icprog/FaboolDSPcba/README.md

#FABOOL Laser DS PCBA
- Product page: https://www.smartdiys.cc/fabool-laser-ds/
- Shop page: https://shop.smartdiys.cc/collections/80w-co2-laser-cutter-and-engraver
