icprog/FaboolDSPcba/LaserDSBoard/report.txt

情報: ネットリストファイル "D:\work\FaboolDSPcba\LaserDSBoard\LaserDSBoard.net"を読み込んでいます。

情報: コンポーネントとフットプリントの関連付けにリファレンスを使用

* 警告: コンポーネント 'J3' ：ボードのフットプリント 'B2B-XH-A' ：ネットリストのフットプリント 'mylib:VH-4'

* 警告: コンポーネント 'J15' ：ボードのフットプリント 'B4B-XH-A' ：ネットリストのフットプリント 'mylib:VH-4'

* 警告: コンポーネント 'J14' ：ボードのフットプリント 'B4B-XH-A' ：ネットリストのフットプリント 'mylib:VH-4'

* 警告: コンポーネント 'J16' ：ボードのフットプリント 'B4B-XH-A' ：ネットリストのフットプリント 'mylib:VH-4'

* 警告: コンポーネント 'U14' ：ボードのフットプリント 'TLP2355' ：ネットリストのフットプリント 'mylib:TLP2355'

* 警告: コンポーネント 'U12' ：ボードのフットプリント 'TLP2355' ：ネットリストのフットプリント 'mylib:TLP2355'

* 警告: コンポーネント 'U7' ：ボードのフットプリント 'TLP627' ：ネットリストのフットプリント 'mylib:TLP2355'

* 警告: コンポーネント 'U8' ：ボードのフットプリント 'TSSOP-20' ：ネットリストのフットプリント 'mylib:TLP2355'

* 警告: コンポーネント 'U9' ：ボードのフットプリント 'TLP627' ：ネットリストのフットプリント 'mylib:TLP2355'

* 警告: コンポーネント 'U10' ：ボードのフットプリント 'TSSOP-14' ：ネットリストのフットプリント 'mylib:TLP2355'

* 警告: コンポーネント 'U13' ：ボードのフットプリント 'TLP2355' ：ネットリストのフットプリント 'mylib:TLP2355'

* 警告: コンポーネント 'U17' ：ボードのフットプリント 'TLP2355' ：ネットリストのフットプリント 'mylib:TLP2355'

* 警告: コンポーネント 'U18' ：ボードのフットプリント 'TSOP-5' ：ネットリストのフットプリント 'mylib:TLP2355'

* 警告: コンポーネント 'U15' ：ボードのフットプリント 'TLP2355' ：ネットリストのフットプリント 'mylib:TLP2355'

* 警告: コンポーネント 'U22' ：ボードのフットプリント 'TLP2355' ：ネットリストのフットプリント 'mylib:TLP2355'

* 警告: コンポーネント 'U16' ：ボードのフットプリント 'TLP2355' ：ネットリストのフットプリント 'mylib:TLP2355'

* 警告: コンポーネント 'U6' ：ボードのフットプリント 'TLP627-4' ：ネットリストのフットプリント 'mylib:TLP2355'

* 警告: コンポーネント 'SW2' ：ボードのフットプリント 'MS-22D18' ：ネットリストのフットプリント 'mylib:SSSS213202'

* 警告: コンポーネント 'J10' ：ボードのフットプリント 'B2B-XH-A' ：ネットリストのフットプリント 'mylib:S3B-XH-SM4-TB'

* 警告: コンポーネント 'J5' ：ボードのフットプリント 'B2B-XH-A' ：ネットリストのフットプリント 'mylib:S3B-XH-SM4-TB'

* 警告: コンポーネント 'J7' ：ボードのフットプリント 'B2B-XH-A' ：ネットリストのフットプリント 'mylib:S3B-XH-SM4-TB'

* 警告: コンポーネント 'J8' ：ボードのフットプリント 'B2B-XH-A' ：ネットリストのフットプリント 'mylib:S3B-XH-SM4-TB'

* 警告: コンポーネント 'J9' ：ボードのフットプリント 'B2B-XH-A' ：ネットリストのフットプリント 'mylib:S3B-XH-SM4-TB'

* 警告: コンポーネント 'J4' ：ボードのフットプリント 'B2B-XH-A' ：ネットリストのフットプリント 'mylib:S3B-XH-SM4-TB'

* 警告: コンポーネント 'J11' ：ボードのフットプリント 'B3B-XH-A' ：ネットリストのフットプリント 'mylib:S3B-XH-SM4-TB'

* 警告: コンポーネント 'J6' ：ボードのフットプリント 'B3B-XH-A' ：ネットリストのフットプリント 'mylib:S3B-XH-SM4-TB'

* 警告: コンポーネント 'U19' ：ボードのフットプリント 'SOT23_6' ：ネットリストのフットプリント 'mylib:MCP3425'

* 警告: コンポーネント 'U1' ：ボードのフットプリント 'SOT-223' ：ネットリストのフットプリント 'mylib:LD1117S33TR'

* 警告: コンポーネント 'U4' ：ボードのフットプリント 'SOT-223' ：ネットリストのフットプリント 'mylib:LD1117S33TR'

* 警告: コンポーネント 'U2' ：ボードのフットプリント 'SOT-223' ：ネットリストのフットプリント 'mylib:LD1117S33TR'

* 警告: コンポーネント 'SW1' ：ボードのフットプリント 'DHT-1163S' ：ネットリストのフットプリント 'mylib:DHT-1163S'

* 警告: コンポーネント 'L1' ：ボードのフットプリント 'C_0805' ：ネットリストのフットプリント 'mylib:BNX024H01'

* 警告: コンポーネント 'U11' ：ボードのフットプリント 'SOIC-8' ：ネットリストのフットプリント 'mylib:ADUM1250'

* 警告: コンポーネント 'U20' ：ボードのフットプリント 'TSSOP-24-thin_pads' ：ネットリストのフットプリント 'mylib:A4982SLPTR'

* 警告: コンポーネント 'U21' ：ボードのフットプリント 'TSSOP-24-thin_pads' ：ネットリストのフットプリント 'mylib:A4982SLPTR'

* 警告: コンポーネント 'R37' ：ボードのフットプリント 'R_0603' ：ネットリストのフットプリント 'Resistors_SMD:R_1206'

* 警告: コンポーネント 'R28' ：ボードのフットプリント 'R_0603' ：ネットリストのフットプリント 'Resistors_SMD:R_1206'

* 警告: コンポーネント 'R41' ：ボードのフットプリント 'R_1206' ：ネットリストのフットプリント 'Resistors_SMD:R_1206'

* 警告: コンポーネント 'R4' ：ボードのフットプリント 'R_0603' ：ネットリストのフットプリント 'Resistors_SMD:R_1206'

* 警告: コンポーネント 'R65' ：ボードのフットプリント 'R_1206' ：ネットリストのフットプリント 'Resistors_SMD:R_1206'

* 警告: コンポーネント 'R6' ：ボードのフットプリント 'R_1206' ：ネットリストのフットプリント 'Resistors_SMD:R_1206'

* 警告: コンポーネント 'R40' ：ボードのフットプリント 'R_0603' ：ネットリストのフットプリント 'Resistors_SMD:R_1206'

* 警告: コンポーネント 'R57' ：ボードのフットプリント 'R_0603' ：ネットリストのフットプリント 'Resistors_SMD:R_1206'

* 警告: コンポーネント 'R59' ：ボードのフットプリント 'R_0603' ：ネットリストのフットプリント 'Resistors_SMD:R_1206'

* 警告: コンポーネント 'R58' ：ボードのフットプリント 'R_0603' ：ネットリストのフットプリント 'Resistors_SMD:R_1206'

* 警告: コンポーネント 'R9' ：ボードのフットプリント 'R_1206' ：ネットリストのフットプリント 'Resistors_SMD:R_1206'

* 警告: コンポーネント 'R17' ：ボードのフットプリント 'R_1206' ：ネットリストのフットプリント 'Resistors_SMD:R_1206'

* 警告: コンポーネント 'R16' ：ボードのフットプリント 'R_1206' ：ネットリストのフットプリント 'Resistors_SMD:R_1206'

* 警告: コンポーネント 'R15' ：ボードのフットプリント 'R_1206' ：ネットリストのフットプリント 'Resistors_SMD:R_1206'

* 警告: コンポーネント 'R60' ：ボードのフットプリント 'R_0603' ：ネットリストのフットプリント 'Resistors_SMD:R_1206'

* 警告: コンポーネント 'R10' ：ボードのフットプリント 'R_1206' ：ネットリストのフットプリント 'Resistors_SMD:R_1206'

* 警告: コンポーネント 'R56' ：ボードのフットプリント 'R_0603' ：ネットリストのフットプリント 'Resistors_SMD:R_1206'

* 警告: コンポーネント 'R51' ：ボードのフットプリント 'R_0603' ：ネットリストのフットプリント 'Resistors_SMD:R_1206'

* 警告: コンポーネント 'R55' ：ボードのフットプリント 'R_0603' ：ネットリストのフットプリント 'Resistors_SMD:R_1206'

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

コンポーネントを "C21:/56CE9D67" ピン "2" ネット名を， "GND" から "GNDD" に変更．

情報: ネットリストよりコンポーネントとフットプリントをチェックしています "C22:/56DE961B:Capacitors_SMD:C_0805"。

コンポーネントを "C22:/56DE961B" ピン "1" ネット名を， "+3.3V" から "D+3.3V" に変更．

コンポーネントを "C22:/56DE961B" ピン "2" ネット名を， "GND" から "GNDD" に変更．

情報: ネットリストよりコンポーネントとフットプリントをチェックしています "C23:/5A8243E8:Capacitors_SMD:C_0805"。

コンポーネント "C23:/5A35896F" の値を， "0u1" から "0.1u" に変更．

情報: コンポーネントのパス， "C23:/5A35896F" を "/5A8243E8" に変更．

コンポーネントを "C23:/5A8243E8" ピン "1" ネット名を， "GND" から "A+12V" に変更．

コンポーネントを "C23:/5A8243E8" ピン "2" ネット名を， "X_LIMIT1" から "GNDA" に変更．

情報: ネットリストよりコンポーネントとフットプリントをチェックしています "C24:/5A7D0A2E:Capacitors_SMD:C_0805"。

情報: コンポーネントのパス， "C24:/5A35898F" を "/5A7D0A2E" に変更．

コンポーネントを "C24:/5A7D0A2E" ピン "1" ネット名を， "GND" から "A+3.3V" に変更．

コンポーネントを "C24:/5A7D0A2E" ピン "2" ネット名を， "X_LIMIT2" から "GNDA" に変更．

情報: ネットリストよりコンポーネントとフットプリントをチェックしています "C25:/5A83414A:Capacitors_SMD:C_0805"。

情報: コンポーネントのパス， "C25:/5A3589AF" を "/5A83414A" に変更．

コンポーネントを "C25:/5A83414A" ピン "1" ネット名を， "GND" から "X_LIMIT1" に変更．

コンポーネントを "C25:/5A83414A" ピン "2" ネット名を， "Y_LIMIT1" から "GNDD" に変更．

情報: ネットリストよりコンポーネントとフットプリントをチェックしています "C26:/5A8343A4:Capacitors_SMD:C_0805"。

情報: コンポーネントのパス， "C26:/5A3589CF" を "/5A8343A4" に変更．

コンポーネントを "C26:/5A8343A4" ピン "1" ネット名を， "GND" から "X_LIMIT2" に変更．

コンポーネントを "C26:/5A8343A4" ピン "2" ネット名を， "Y_LIMIT2" から "GNDD" に変更．

情報: ネットリストよりコンポーネントとフットプリントをチェックしています "C27:/5A358B85:Capacitors_SMD:C_0805"。

コンポーネントを "C27:/5A358B85" ピン "1" ネット名を， "DGND" から "GNDA" に変更．

コンポーネントを "C27:/5A358B85" ピン "2" ネット名を， "D33V" から "A+3.3V" に変更．

情報: ネットリストよりコンポーネントとフットプリントをチェックしています "C28:/5A8345DB:Capacitors_SMD:C_0805"。

情報: コンポーネントのパス， "C28:/56CEA9CC" を "/5A8345DB" に変更．

コンポーネントを "C28:/5A8345DB" ピン "1" ネット名を， "GND" から "Y_LIMIT1" に変更．

コンポーネントを "C28:/5A8345DB" ピン "2" ネット名を， "D_SWITCH" から "GNDD" に変更．

情報: ネットリストよりコンポーネントとフットプリントをチェックしています "C29:/56CEA8C7:Capacitors_SMD:C_0805"。

コンポーネントを "C29:/56CEA8C7" ピン "1" ネット名を， "D33V" から "A+3.3V" に変更．

コンポーネントを "C29:/56CEA8C7" ピン "2" ネット名を， "DGND" から "GNDA" に変更．

情報: ネットリストよりコンポーネントとフットプリントをチェックしています "C30:/5A353B5C:Capacitors_SMD:C_0805"。

コンポーネントを "C30:/5A353B5C" ピン "1" ネット名を， "+3.3V" から "D+3.3V" に変更．

コンポーネントを "C30:/5A353B5C" ピン "2" ネット名を， "GND" から "GNDD" に変更．

情報: ネットリストよりコンポーネントとフットプリントをチェックしています "C31:/5A354B5E:Capacitors_SMD:C_0805"。

コンポーネントを "C31:/5A354B5E" ピン "1" ネット名を， "D33V" から "A+3.3V" に変更．

コンポーネントを "C31:/5A354B5E" ピン "2" ネット名を， "DGND" から "GNDA" に変更．

情報: ネットリストよりコンポーネントとフットプリントをチェックしています "C32:/56CEA932:Capacitors_SMD:C_0603"。

コンポーネントを "C32:/56CEA932" ピン "1" ネット名を， "N-0000055" から "Net-(C32-Pad1)" に変更．

コンポーネントを "C32:/56CEA932" ピン "2" ネット名を， "DGND" から "GNDA" に変更．

情報: ネットリストよりコンポーネントとフットプリントをチェックしています "C33:/5A354834:Capacitors_SMD:C_0805"。

コンポーネントを "C33:/5A354834" ピン "1" ネット名を， "N-00000100" から "Net-(C33-Pad1)" に変更．

コンポーネントを "C33:/5A354834" ピン "2" ネット名を， "DGND" から "GNDA" に変更．

情報: ネットリストよりコンポーネントとフットプリントをチェックしています "C34:/56CEA9A0:Capacitors_SMD:C_0603"。

コンポーネントを "C34:/56CEA9A0" ピン "1" ネット名を， "N-0000065" から "Net-(C34-Pad1)" に変更．

コンポーネントを "C34:/56CEA9A0" ピン "2" ネット名を， "DGND" から "GNDA" に変更．

情報: ネットリストよりコンポーネントとフットプリントをチェックしています "C35:/56CEA852:Capacitors_SMD:C_0805"。

コンポーネントを "C35:/56CEA852" ピン "1" ネット名を， "DGND" から "GNDA" に変更．

コンポーネントを "C35:/56CEA852" ピン "2" ネット名を， "D12V" から "A+12V" に変更．

情報: ネットリストよりコンポーネントとフットプリントをチェックしています "C36:/56CEA858:Capacitors_SMD:C_0805"。

コンポーネントを "C36:/56CEA858" ピン "1" ネット名を， "DGND" から "GNDA" に変更．

コンポーネントを "C36:/56CEA858" ピン "2" ネット名を， "D12V" から "A+12V" に変更．

情報: ネットリストよりコンポーネントとフットプリントをチェックしています "C37:/56CEA8D9:Capacitors_SMD:CP_Elec_6.3x7.7"。

コンポーネントを "C37:/56CEA8D9" ピン "1" ネット名を， "D12V" から "A+12V" に変更．

コンポーネントを "C37:/56CEA8D9" ピン "2" ネット名を， "DGND" から "GNDA" に変更．

情報: ネットリストよりコンポーネントとフットプリントをチェックしています "C38:/56CEA8DF:Capacitors_SMD:CP_Elec_6.3x7.7"。

コンポーネントを "C38:/56CEA8DF" ピン "1" ネット名を， "D12V" から "A+12V" に変更．

コンポーネントを "C38:/56CEA8DF" ピン "2" ネット名を， "DGND" から "GNDA" に変更．

情報: ネットリストよりコンポーネントとフットプリントをチェックしています "C39:/5A354B64:Capacitors_SMD:C_0805"。

コンポーネントを "C39:/5A354B64" ピン "1" ネット名を， "D33V" から "A+3.3V" に変更．

コンポーネントを "C39:/5A354B64" ピン "2" ネット名を， "DGND" から "GNDA" に変更．

情報: ネットリストよりコンポーネントとフットプリントをチェックしています "C40:/56CEA93E:Capacitors_SMD:C_0805"。

コンポーネントを "C40:/56CEA93E" ピン "1" ネット名を， "N-0000056" から "Net-(C40-Pad1)" に変更．

コンポーネントを "C40:/56CEA93E" ピン "2" ネット名を， "D12V" から "A+12V" に変更．

情報: ネットリストよりコンポーネントとフットプリントをチェックしています "C41:/56CEA994:Capacitors_SMD:C_0805"。

コンポーネントを "C41:/56CEA994" ピン "1" ネット名を， "N-0000070" から "Net-(C41-Pad1)" に変更．

コンポーネントを "C41:/56CEA994" ピン "2" ネット名を， "D12V" から "A+12V" に変更．

情報: ネットリストよりコンポーネントとフットプリントをチェックしています "C42:/56CEA94A:Capacitors_SMD:C_0603"。

コンポーネントを "C42:/56CEA94A" ピン "1" ネット名を， "D33V" から "A+3.3V" に変更．

コンポーネントを "C42:/56CEA94A" ピン "2" ネット名を， "DGND" から "GNDA" に変更．

情報: ネットリストよりコンポーネントとフットプリントをチェックしています "C43:/56CEA988:Capacitors_SMD:C_0603"。

コンポーネントを "C43:/56CEA988" ピン "1" ネット名を， "D33V" から "A+3.3V" に変更．

コンポーネントを "C43:/56CEA988" ピン "2" ネット名を， "DGND" から "GNDA" に変更．

情報: ネットリストよりコンポーネントとフットプリントをチェックしています "C44:/56CEA81C:Capacitors_SMD:C_0805"。

コンポーネントを "C44:/56CEA81C" ピン "1" ネット名を， "N-0000040" から "Net-(C44-Pad1)" に変更．

コンポーネントを "C44:/56CEA81C" ピン "2" ネット名を， "N-0000039" から "Net-(C44-Pad2)" に変更．

情報: ネットリストよりコンポーネントとフットプリントをチェックしています "C45:/56CEA822:Capacitors_SMD:C_0805"。

コンポーネントを "C45:/56CEA822" ピン "1" ネット名を， "N-0000037" から "Net-(C45-Pad1)" に変更．

コンポーネントを "C45:/56CEA822" ピン "2" ネット名を， "N-0000038" から "Net-(C45-Pad2)" に変更．

情報: ネットリストよりコンポーネントとフットプリントをチェックしています "C46:/56CEA86B:Capacitors_SMD:C_0805"。

コンポーネントを "C46:/56CEA86B" ピン "2" ネット名を， "DGND" から "GNDA" に変更．

情報: ネットリストよりコンポーネントとフットプリントをチェックしています "C47:/56CEA871:Capacitors_SMD:C_0805"。

コンポーネントを "C47:/56CEA871" ピン "2" ネット名を， "DGND" から "GNDA" に変更．

情報: ネットリストよりコンポーネントとフットプリントをチェックしています "C48:/5A834815:Capacitors_SMD:C_0805"。

コンポーネント "C48:/5A834815" フットプリント "Capacitors_SMD:C_0805" を追加します。

コンポーネントを "C48:/5A834815" ピン "1" ネット名を， "" から "Y_LIMIT2" に変更．

コンポーネントを "C48:/5A834815" ピン "2" ネット名を， "" から "GNDD" に変更．

情報: ネットリストよりコンポーネントとフットプリントをチェックしています "C49:/5A8A227D:Capacitors_SMD:C_0805"。

コンポーネント "C49:/5A8A227D" フットプリント "Capacitors_SMD:C_0805" を追加します。

コンポーネントを "C49:/5A8A227D" ピン "1" ネット名を， "" から "D_SWITCH" に変更．

コンポーネントを "C49:/5A8A227D" ピン "2" ネット名を， "" から "GNDD" に変更．

情報: ネットリストよりコンポーネントとフットプリントをチェックしています "C50:/5A990A10:Capacitors_SMD:C_0603"。

コンポーネント "C50:/5A990A10" フットプリント "Capacitors_SMD:C_0603" を追加します。

コンポーネントを "C50:/5A990A10" ピン "2" ネット名を， "" から "GNDA" に変更．

コンポーネントを "C50:/5A990A10" ピン "1" ネット名を， "" から "Net-(C50-Pad1)" に変更．

情報: ネットリストよりコンポーネントとフットプリントをチェックしています "C51:/5A9909F1:Capacitors_SMD:C_0805"。

コンポーネント "C51:/5A9909F1" フットプリント "Capacitors_SMD:C_0805" を追加します。

コンポーネントを "C51:/5A9909F1" ピン "1" ネット名を， "" から "GNDA" に変更．

コンポーネントを "C51:/5A9909F1" ピン "2" ネット名を， "" から "A+12V" に変更．

情報: ネットリストよりコンポーネントとフットプリントをチェックしています "C52:/5A9909FD:Capacitors_SMD:CP_Elec_6.3x7.7"。

コンポーネント "C52:/5A9909FD" フットプリント "Capacitors_SMD:CP_Elec_6.3x7.7" を追加します。

コンポーネントを "C52:/5A9909FD" ピン "1" ネット名を， "" から "A+12V" に変更．

コンポーネントを "C52:/5A9909FD" ピン "2" ネット名を， "" から "GNDA" に変更．

情報: ネットリストよりコンポーネントとフットプリントをチェックしています "C53:/5A990A1C:Capacitors_SMD:C_0805"。

コンポーネント "C53:/5A990A1C" フットプリント "Capacitors_SMD:C_0805" を追加します。

コンポーネントを "C53:/5A990A1C" ピン "1" ネット名を， "" から "Net-(C53-Pad1)" に変更．

コンポーネントを "C53:/5A990A1C" ピン "2" ネット名を， "" から "A+12V" に変更．

情報: ネットリストよりコンポーネントとフットプリントをチェックしています "C54:/5A990A28:Capacitors_SMD:C_0603"。

コンポーネント "C54:/5A990A28" フットプリント "Capacitors_SMD:C_0603" を追加します。

コンポーネントを "C54:/5A990A28" ピン "2" ネット名を， "" から "GNDA" に変更．

コンポーネントを "C54:/5A990A28" ピン "1" ネット名を， "" から "A+3.3V" に変更．

情報: ネットリストよりコンポーネントとフットプリントをチェックしています "C55:/5A9909E5:Capacitors_SMD:C_0805"。

コンポーネント "C55:/5A9909E5" フットプリント "Capacitors_SMD:C_0805" を追加します。

コンポーネントを "C55:/5A9909E5" ピン "1" ネット名を， "" から "Net-(C55-Pad1)" に変更．

コンポーネントを "C55:/5A9909E5" ピン "2" ネット名を， "" から "Net-(C55-Pad2)" に変更．

情報: ネットリストよりコンポーネントとフットプリントをチェックしています "C56:/5A9909F7:Capacitors_SMD:C_0805"。

コンポーネント "C56:/5A9909F7" フットプリント "Capacitors_SMD:C_0805" を追加します。

コンポーネントを "C56:/5A9909F7" ピン "1" ネット名を， "" から "Y_REF" に変更．

コンポーネントを "C56:/5A9909F7" ピン "2" ネット名を， "" から "GNDA" に変更．

情報: ネットリストよりコンポーネントとフットプリントをチェックしています "D1:/56CEA9E9:Diodes_SMD:D_0603"。

コンポーネントを "D1:/56CEA9E9" ピン "2" ネット名を， "N-00000110" から "Net-(D1-Pad2)" に変更．

情報: ネットリストよりコンポーネントとフットプリントをチェックしています "D2:/56CEA807:Diodes_SMD:D_0603"。

コンポーネントを "D2:/56CEA807" ピン "2" ネット名を， "N-0000051" から "Net-(D2-Pad2)" に変更．

コンポーネントを "D2:/56CEA807" ピン "1" ネット名を， "D12V" から "A+12V" に変更．

情報: ネットリストよりコンポーネントとフットプリントをチェックしています "D3:/5A3574DD:Diodes_SMD:D_0603"。

コンポーネントを "D3:/5A3574DD" ピン "2" ネット名を， "N-00000119" から "Net-(D3-Pad2)" に変更．

コンポーネントを "D3:/5A3574DD" ピン "1" ネット名を， "D33V" から "A+3.3V" に変更．

情報: ネットリストよりコンポーネントとフットプリントをチェックしています "D4:/56CEA7EF:Diodes_SMD:D_0603"。

コンポーネントを "D4:/56CEA7EF" ピン "2" ネット名を， "N-0000050" から "Net-(D4-Pad2)" に変更．

コンポーネントを "D4:/56CEA7EF" ピン "1" ネット名を， "D5V" から "A+5V" に変更．

情報: ネットリストよりコンポーネントとフットプリントをチェックしています "D5:/5A7F41D8:Diodes_SMD:D_0603"。

情報: コンポーネントのパス， "D5:/56CEA8A1" を "/5A7F41D8" に変更．

コンポーネントを "D5:/5A7F41D8" ピン "2" ネット名を， "N-0000094" から "Net-(D5-Pad2)" に変更．

コンポーネントを "D5:/5A7F41D8" ピン "1" ネット名を， "N-0000049" から "Net-(D5-Pad1)" に変更．

情報: ネットリストよりコンポーネントとフットプリントをチェックしています "D6:/5A7FC4C0:Diodes_SMD:D_0603"。

情報: コンポーネントのパス， "D6:/57C27BDA" を "/5A7FC4C0" に変更．

コンポーネントを "D6:/5A7FC4C0" ピン "2" ネット名を， "N-0000093" から "Net-(D6-Pad2)" に変更．

コンポーネントを "D6:/5A7FC4C0" ピン "1" ネット名を， "N-0000045" から "Net-(D6-Pad1)" に変更．

情報: ネットリストよりコンポーネントとフットプリントをチェックしています "D7:/5A7FCD76:Diodes_SMD:D_0603"。

情報: コンポーネントのパス， "D7:/56CEA889" を "/5A7FCD76" に変更．

コンポーネントを "D7:/5A7FCD76" ピン "2" ネット名を， "N-0000092" から "Net-(D7-Pad2)" に変更．

コンポーネントを "D7:/5A7FCD76" ピン "1" ネット名を， "N-0000044" から "Net-(D7-Pad1)" に変更．

情報: ネットリストよりコンポーネントとフットプリントをチェックしています "D8:/5A7FCFA8:Diodes_SMD:D_0603"。

情報: コンポーネントのパス， "D8:/57C27BB0" を "/5A7FCFA8" に変更．

コンポーネントを "D8:/5A7FCFA8" ピン "2" ネット名を， "N-0000095" から "Net-(D8-Pad2)" に変更．

コンポーネントを "D8:/5A7FCFA8" ピン "1" ネット名を， "N-0000043" から "Net-(D8-Pad1)" に変更．

情報: ネットリストよりコンポーネントとフットプリントをチェックしています "D9:/56CEA9BE:Diodes_SMD:D_0603"。

コンポーネントを "D9:/56CEA9BE" ピン "2" ネット名を， "N-0000079" から "Net-(D9-Pad2)" に変更．

コンポーネントを "D9:/56CEA9BE" ピン "1" ネット名を， "N-0000078" から "Net-(D9-Pad1)" に変更．

情報: ネットリストよりコンポーネントとフットプリントをチェックしています "J1:/56CEB228:Pin_Headers:Pin_Header_Straight_2x05_Pitch1.00mm"。

コンポーネントを "J1:/56CEB228" ピン "1" ネット名を， "+3.3V" から "D+3.3V" に変更．

コンポーネントを "J1:/56CEB228" ピン "3" ネット名を， "GND" から "GNDD" に変更．

コンポーネントを "J1:/56CEB228" ピン "5" ネット名を， "GND" から "GNDD" に変更．

コンポーネントを "J1:/56CEB228" ピン "7" ネット名を， "" から "Net-(J1-Pad7)" に変更．

コンポーネントを "J1:/56CEB228" ピン "9" ネット名を， "GND" から "GNDD" に変更．

情報: ネットリストよりコンポーネントとフットプリントをチェックしています "J2:/56CEAA33:Connect:USB_B"。

コンポーネントを "J2:/56CEAA33" ピン "2" ネット名を， "N-00000116" から "Net-(J2-Pad2)" に変更．

コンポーネントを "J2:/56CEAA33" ピン "3" ネット名を， "N-00000117" から "Net-(J2-Pad3)" に変更．

コンポーネントを "J2:/56CEAA33" ピン "4" ネット名を， "GND" から "GNDD" に変更．

コンポーネントを "J2:/56CEAA33" ピン "5" ネット名を， "N-00000115" から "GNDD" に変更．

コンポーネントを "J2:/56CEAA33" ピン "6" ネット名を， "N-00000115" から "GNDD" に変更．

情報: ネットリストよりコンポーネントとフットプリントをチェックしています "J3:/57C28AB0:mylib:VH-4"。

コンポーネントを "J3:/57C28AB0" ピン "1" ネット名を， "N-00000106" から "+12P" に変更．

コンポーネントを "J3:/57C28AB0" ピン "2" ネット名を， "N-00000105" から "GNDPWR" に変更．

情報: ネットリストよりコンポーネントとフットプリントをチェックしています "J4:/57C2B94C:mylib:S3B-XH-SM4-TB"。

コンポーネントを "J4:/57C2B94C" ピン "1" ネット名を， "N-0000099" から "Net-(J4-Pad1)" に変更．

コンポーネントを "J4:/57C2B94C" ピン "2" ネット名を， "DGND" から "GNDA" に変更．

情報: ネットリストよりコンポーネントとフットプリントをチェックしています "J5:/5A7B96E2:mylib:S3B-XH-SM4-TB"。

コンポーネント "J5:/56CEABED" の値を， "D SWITCH" から "X LIMIT1" に変更．

情報: コンポーネントのパス， "J5:/56CEABED" を "/5A7B96E2" に変更．

コンポーネントを "J5:/5A7B96E2" ピン "1" ネット名を， "N-0000079" から "Net-(D5-Pad2)" に変更．

コンポーネントを "J5:/5A7B96E2" ピン "2" ネット名を， "DGND" から "GNDA" に変更．

情報: ネットリストよりコンポーネントとフットプリントをチェックしています "J6:/5A353B1D:mylib:S3B-XH-SM4-TB"。

コンポーネントを "J6:/5A353B1D" ピン "1" ネット名を， "D33V" から "A+3.3V" に変更．

コンポーネントを "J6:/5A353B1D" ピン "2" ネット名を， "DGND" から "GNDA" に変更．

コンポーネントを "J6:/5A353B1D" ピン "3" ネット名を， "N-0000082" から "Net-(J6-Pad3)" に変更．

情報: ネットリストよりコンポーネントとフットプリントをチェックしています "J7:/5A7BB8D3:mylib:S3B-XH-SM4-TB"。

コンポーネント "J7:/56CEABD5" の値を， "X LIMIT1" から "X LIMIT2" に変更．

情報: コンポーネントのパス， "J7:/56CEABD5" を "/5A7BB8D3" に変更．

コンポーネントを "J7:/5A7BB8D3" ピン "1" ネット名を， "N-0000094" から "Net-(D6-Pad2)" に変更．

コンポーネントを "J7:/5A7BB8D3" ピン "2" ネット名を， "DGND" から "GNDA" に変更．

情報: ネットリストよりコンポーネントとフットプリントをチェックしています "J8:/5A7BBADF:mylib:S3B-XH-SM4-TB"。

コンポーネント "J8:/57C2BE86" の値を， "X LIMIT2" から "Y LIMIT1" に変更．

情報: コンポーネントのパス， "J8:/57C2BE86" を "/5A7BBADF" に変更．

コンポーネントを "J8:/5A7BBADF" ピン "1" ネット名を， "N-0000093" から "Net-(D7-Pad2)" に変更．

コンポーネントを "J8:/5A7BBADF" ピン "2" ネット名を， "DGND" から "GNDA" に変更．

情報: ネットリストよりコンポーネントとフットプリントをチェックしています "J9:/5A7BBCEA:mylib:S3B-XH-SM4-TB"。

コンポーネント "J9:/56CEABE1" の値を， "Y LIMIT1" から "Y LIMIT2" に変更．

情報: コンポーネントのパス， "J9:/56CEABE1" を "/5A7BBCEA" に変更．

コンポーネントを "J9:/5A7BBCEA" ピン "1" ネット名を， "N-0000092" から "Net-(D8-Pad2)" に変更．

コンポーネントを "J9:/5A7BBCEA" ピン "2" ネット名を， "DGND" から "GNDA" に変更．

情報: ネットリストよりコンポーネントとフットプリントをチェックしています "J10:/5A892CFF:mylib:S3B-XH-SM4-TB"。

コンポーネント "J10:/57C2BE96" の値を， "Y LIMIT2" から "D SWITCH" に変更．

情報: コンポーネントのパス， "J10:/57C2BE96" を "/5A892CFF" に変更．

コンポーネントを "J10:/5A892CFF" ピン "1" ネット名を， "N-0000095" から "Net-(D9-Pad2)" に変更．

コンポーネントを "J10:/5A892CFF" ピン "2" ネット名を， "DGND" から "GNDA" に変更．

情報: ネットリストよりコンポーネントとフットプリントをチェックしています "J11:/5A9B8B22:mylib:S3B-XH-SM4-TB"。

情報: コンポーネントのパス， "J11:/57C30135" を "/5A9B8B22" に変更．

コンポーネントを "J11:/5A9B8B22" ピン "1" ネット名を， "N-00000114" から "Net-(J11-Pad1)" に変更．

コンポーネントを "J11:/5A9B8B22" ピン "2" ネット名を， "" から "Net-(J11-Pad2)" に変更．

コンポーネントを "J11:/5A9B8B22" ピン "3" ネット名を， "DGND" から "GNDA" に変更．

情報: ネットリストよりコンポーネントとフットプリントをチェックしています "J12:/56CEA846:Pin_Headers:Pin_Header_Straight_1x01_Pitch1.00mm"。

情報: ネットリストよりコンポーネントとフットプリントをチェックしています "J13:/56CEA840:Pin_Headers:Pin_Header_Straight_1x01_Pitch1.00mm"。

情報: ネットリストよりコンポーネントとフットプリントをチェックしています "J14:/56CEAA51:mylib:VH-4"。

コンポーネントを "J14:/56CEAA51" ピン "1" ネット名を， "Y_MOT_2B" から "Y1_MOT_2B" に変更．

コンポーネントを "J14:/56CEAA51" ピン "2" ネット名を， "Y_MOT_2A" から "Y1_MOT_2A" に変更．

コンポーネントを "J14:/56CEAA51" ピン "3" ネット名を， "Y_MOT_1A" から "Y1_MOT_1A" に変更．

コンポーネントを "J14:/56CEAA51" ピン "4" ネット名を， "Y_MOT_1B" から "Y1_MOT_1B" に変更．

情報: ネットリストよりコンポーネントとフットプリントをチェックしています "J15:/56CEAA4B:mylib:VH-4"。

情報: ネットリストよりコンポーネントとフットプリントをチェックしています "J16:/56CEAA57:mylib:VH-4"。

コンポーネントを "J16:/56CEAA57" ピン "1" ネット名を， "Y_MOT_2B" から "Y2_MOT_2B" に変更．

コンポーネントを "J16:/56CEAA57" ピン "2" ネット名を， "Y_MOT_2A" から "Y2_MOT_2A" に変更．

コンポーネントを "J16:/56CEAA57" ピン "3" ネット名を， "Y_MOT_1A" から "Y2_MOT_1A" に変更．

コンポーネントを "J16:/56CEAA57" ピン "4" ネット名を， "Y_MOT_1B" から "Y2_MOT_1B" に変更．

情報: ネットリストよりコンポーネントとフットプリントをチェックしています "J17:/5A9909EB:Pin_Headers:Pin_Header_Straight_1x01_Pitch1.00mm"。

コンポーネント "J17:/5A9909EB" フットプリント "Pin_Headers:Pin_Header_Straight_1x01_Pitch1.00mm" を追加します。

コンポーネントを "J17:/5A9909EB" ピン "1" ネット名を， "" から "Y_REF" に変更．

情報: ネットリストよりコンポーネントとフットプリントをチェックしています "L1:/5A80D58A:mylib:BNX024H01"。

コンポーネント "L1:/586DF2CD" の値を， "BLM21SN300SN1D" から "BNX024H01" に変更．

情報: コンポーネントのパス， "L1:/586DF2CD" を "/5A80D58A" に変更．

コンポーネントを "L1:/5A80D58A" ピン "1" ネット名を， "D12V" から "+12P" に変更．

コンポーネントを "L1:/5A80D58A" ピン "2" ネット名を， "N-00000106" から "A+12V" に変更．

情報: ネットリストよりコンポーネントとフットプリントをチェックしています "L4:/56CEB62F:Resistors_SMD:R_0603"。

コンポーネント "L4:/56CEB62F" の値を， "Ferrite bead" から "LI0603G221R-10" に変更．

コンポーネントを "L4:/56CEB62F" ピン "1" ネット名を， "+3.3V" から "D+3.3V" に変更．

情報: ネットリストよりコンポーネントとフットプリントをチェックしています "R1:/5726C39C:Resistors_SMD:R_0603"。

コンポーネントを "R1:/5726C39C" ピン "1" ネット名を， "N-00000108" から "Net-(R1-Pad1)" に変更．

コンポーネントを "R1:/5726C39C" ピン "2" ネット名を， "GND" から "GNDD" に変更．

情報: ネットリストよりコンポーネントとフットプリントをチェックしています "R2:/5A7F3F8A:Resistors_SMD:R_0603"。

コンポーネント "R2:/5A34BFA6" の値を， "220R" から "4k7" に変更．

情報: コンポーネントのパス， "R2:/5A34BFA6" を "/5A7F3F8A" に変更．

コンポーネントを "R2:/5A7F3F8A" ピン "1" ネット名を， "N-00000128" から "Net-(D5-Pad1)" に変更．

コンポーネントを "R2:/5A7F3F8A" ピン "2" ネット名を， "D12V" から "A+12V" に変更．

情報: ネットリストよりコンポーネントとフットプリントをチェックしています "R3:/5A7FC6EC:Resistors_SMD:R_0603"。

コンポーネント "R3:/5A34BFCA" の値を， "220R" から "4k7" に変更．

情報: コンポーネントのパス， "R3:/5A34BFCA" を "/5A7FC6EC" に変更．

コンポーネントを "R3:/5A7FC6EC" ピン "1" ネット名を， "N-00000129" から "Net-(D6-Pad1)" に変更．

コンポーネントを "R3:/5A7FC6EC" ピン "2" ネット名を， "N-00000128" から "A+12V" に変更．

情報: ネットリストよりコンポーネントとフットプリントをチェックしています "R4:/56DE8B17:Resistors_SMD:R_1206"。

コンポーネントを "R4:/56DE8B17" ピン "1" ネット名を， "N-00000110" から "Net-(D1-Pad2)" に変更．

コンポーネントを "R4:/56DE8B17" ピン "2" ネット名を， "GND" から "GNDD" に変更．

情報: ネットリストよりコンポーネントとフットプリントをチェックしています "R5:/5A7FC917:Resistors_SMD:R_0603"。

コンポーネント "R5:/5A34BFB8" の値を， "220R" から "4k7" に変更．

情報: コンポーネントのパス， "R5:/5A34BFB8" を "/5A7FC917" に変更．

コンポーネントを "R5:/5A7FC917" ピン "1" ネット名を， "N-00000127" から "Net-(D7-Pad1)" に変更．

コンポーネントを "R5:/5A7FC917" ピン "2" ネット名を， "D12V" から "A+12V" に変更．

情報: ネットリストよりコンポーネントとフットプリントをチェックしています "R6:/5A9B8B28:Resistors_SMD:R_1206"。

情報: コンポーネントのパス， "R6:/5A34BFD0" を "/5A9B8B28" に変更．

コンポーネントを "R6:/5A9B8B28" ピン "1" ネット名を， "N-00000129" から "Net-(R6-Pad1)" に変更．

コンポーネントを "R6:/5A9B8B28" ピン "2" ネット名を， "N-00000127" から "LASER_OUT" に変更．

情報: ネットリストよりコンポーネントとフットプリントをチェックしています "R7:/5A7FCB45:Resistors_SMD:R_0603"。

コンポーネント "R7:/5A34BFBE" の値を， "220R" から "4k7" に変更．

情報: コンポーネントのパス， "R7:/5A34BFBE" を "/5A7FCB45" に変更．

コンポーネントを "R7:/5A7FCB45" ピン "1" ネット名を， "N-00000126" から "Net-(D8-Pad1)" に変更．

コンポーネントを "R7:/5A7FCB45" ピン "2" ネット名を， "D12V" から "A+12V" に変更．

情報: ネットリストよりコンポーネントとフットプリントをチェックしています "R8:/5A85E8DC:Resistors_SMD:R_0603"。

コンポーネント "R8:/5A34BFD6" の値を， "220R" から "4k7" に変更．

情報: コンポーネントのパス， "R8:/5A34BFD6" を "/5A85E8DC" に変更．

コンポーネントを "R8:/5A85E8DC" ピン "1" ネット名を， "N-00000129" から "Net-(D9-Pad1)" に変更．

コンポーネントを "R8:/5A85E8DC" ピン "2" ネット名を， "N-00000126" から "A+12V" に変更．

情報: ネットリストよりコンポーネントとフットプリントをチェックしています "R9:/5A885D6C:Resistors_SMD:R_1206"。

コンポーネント "R9:/5A34BFC4" の値を， "220R" から "1k" に変更．

情報: コンポーネントのパス， "R9:/5A34BFC4" を "/5A885D6C" に変更．

コンポーネントを "R9:/5A885D6C" ピン "1" ネット名を， "N-00000125" から "A+12V" に変更．

コンポーネントを "R9:/5A885D6C" ピン "2" ネット名を， "D12V" から "Net-(R9-Pad2)" に変更．

情報: ネットリストよりコンポーネントとフットプリントをチェックしています "R10:/5A7DA5C0:Resistors_SMD:R_1206"。

コンポーネント "R10:/5A34BFDC" の値を， "220R" から "1k" に変更．

情報: コンポーネントのパス， "R10:/5A34BFDC" を "/5A7DA5C0" に変更．

コンポーネントを "R10:/5A7DA5C0" ピン "1" ネット名を， "N-00000129" から "A+12V" に変更．

コンポーネントを "R10:/5A7DA5C0" ピン "2" ネット名を， "N-00000125" から "Net-(R10-Pad2)" に変更．

情報: ネットリストよりコンポーネントとフットプリントをチェックしています "R11:/56CEB21F:Resistors_SMD:R_0603"。

コンポーネントを "R11:/56CEB21F" ピン "1" ネット名を， "+3.3V" から "D+3.3V" に変更．

情報: ネットリストよりコンポーネントとフットプリントをチェックしています "R12:/56CEB260:Resistors_SMD:R_0603"。

コンポーネントを "R12:/56CEB260" ピン "1" ネット名を， "+3.3V" から "D+3.3V" に変更．

情報: ネットリストよりコンポーネントとフットプリントをチェックしています "R13:/56CEB219:Resistors_SMD:R_0603"。

コンポーネントを "R13:/56CEB219" ピン "1" ネット名を， "+3.3V" から "D+3.3V" に変更．

情報: ネットリストよりコンポーネントとフットプリントをチェックしています "R14:/56CEB213:Resistors_SMD:R_0603"。

コンポーネントを "R14:/56CEB213" ピン "1" ネット名を， "+3.3V" から "D+3.3V" に変更．

情報: ネットリストよりコンポーネントとフットプリントをチェックしています "R15:/5A7DE331:Resistors_SMD:R_1206"。

コンポーネント "R15:/5A34BFE2" の値を， "220R" から "1k" に変更．

情報: コンポーネントのパス， "R15:/5A34BFE2" を "/5A7DE331" に変更．

コンポーネントを "R15:/5A7DE331" ピン "1" ネット名を， "N-00000124" から "A+12V" に変更．

コンポーネントを "R15:/5A7DE331" ピン "2" ネット名を， "D12V" から "Net-(R15-Pad2)" に変更．

情報: ネットリストよりコンポーネントとフットプリントをチェックしています "R16:/5A7DE544:Resistors_SMD:R_1206"。

コンポーネント "R16:/5A34BFFA" の値を， "220R" から "1k" に変更．

情報: コンポーネントのパス， "R16:/5A34BFFA" を "/5A7DE544" に変更．

コンポーネントを "R16:/5A7DE544" ピン "1" ネット名を， "N-00000130" から "A+12V" に変更．

コンポーネントを "R16:/5A7DE544" ピン "2" ネット名を， "N-00000124" から "Net-(R16-Pad2)" に変更．

情報: ネットリストよりコンポーネントとフットプリントをチェックしています "R17:/5A7DE760:Resistors_SMD:R_1206"。

コンポーネント "R17:/5A34BFE8" の値を， "220R" から "1k" に変更．

情報: コンポーネントのパス， "R17:/5A34BFE8" を "/5A7DE760" に変更．

コンポーネントを "R17:/5A7DE760" ピン "1" ネット名を， "N-00000123" から "A+12V" に変更．

コンポーネントを "R17:/5A7DE760" ピン "2" ネット名を， "D12V" から "Net-(R17-Pad2)" に変更．

情報: ネットリストよりコンポーネントとフットプリントをチェックしています "R18:/5A824FD0:Resistors_SMD:R_0603"。

コンポーネント "R18:/5A34C000" の値を， "220R" から "1k" に変更．

情報: コンポーネントのパス， "R18:/5A34C000" を "/5A824FD0" に変更．

コンポーネントを "R18:/5A824FD0" ピン "1" ネット名を， "N-00000130" から "D+3.3V" に変更．

コンポーネントを "R18:/5A824FD0" ピン "2" ネット名を， "N-00000123" から "X_LIMIT1" に変更．

情報: ネットリストよりコンポーネントとフットプリントをチェックしています "R19:/5A824FD6:Resistors_SMD:R_0603"。

コンポーネント "R19:/5A34BFEE" の値を， "220R" から "1k" に変更．

情報: コンポーネントのパス， "R19:/5A34BFEE" を "/5A824FD6" に変更．

コンポーネントを "R19:/5A824FD6" ピン "1" ネット名を， "N-00000122" から "D+3.3V" に変更．

コンポーネントを "R19:/5A824FD6" ピン "2" ネット名を， "D12V" から "X_LIMIT2" に変更．

情報: ネットリストよりコンポーネントとフットプリントをチェックしています "R20:/5A824FDC:Resistors_SMD:R_0603"。

コンポーネント "R20:/5A34C006" の値を， "220R" から "1k" に変更．

情報: コンポーネントのパス， "R20:/5A34C006" を "/5A824FDC" に変更．

コンポーネントを "R20:/5A824FDC" ピン "1" ネット名を， "N-00000130" から "D+3.3V" に変更．

コンポーネントを "R20:/5A824FDC" ピン "2" ネット名を， "N-00000122" から "Y_LIMIT1" に変更．

情報: ネットリストよりコンポーネントとフットプリントをチェックしています "R21:/56CEE33E:Resistors_SMD:R_0603"。

コンポーネントを "R21:/56CEE33E" ピン "1" ネット名を， "N-00000117" から "Net-(J2-Pad3)" に変更．

情報: ネットリストよりコンポーネントとフットプリントをチェックしています "R22:/56CEE32C:Resistors_SMD:R_0603"。

コンポーネントを "R22:/56CEE32C" ピン "1" ネット名を， "N-00000116" から "Net-(J2-Pad2)" に変更．

情報: ネットリストよりコンポーネントとフットプリントをチェックしています "R23:/5A824FE2:Resistors_SMD:R_0603"。

コンポーネント "R23:/5A34BFF4" の値を， "220R" から "1k" に変更．

情報: コンポーネントのパス， "R23:/5A34BFF4" を "/5A824FE2" に変更．

コンポーネントを "R23:/5A824FE2" ピン "1" ネット名を， "N-00000121" から "D+3.3V" に変更．

コンポーネントを "R23:/5A824FE2" ピン "2" ネット名を， "D12V" から "Y_LIMIT2" に変更．

情報: ネットリストよりコンポーネントとフットプリントをチェックしています "R24:/5A8671DB:Resistors_SMD:R_0603"。

コンポーネント "R24:/5A34C00C" の値を， "220R" から "1k" に変更．

情報: コンポーネントのパス， "R24:/5A34C00C" を "/5A8671DB" に変更．

コンポーネントを "R24:/5A8671DB" ピン "1" ネット名を， "N-00000130" から "D+3.3V" に変更．

コンポーネントを "R24:/5A8671DB" ピン "2" ネット名を， "N-00000121" から "D_SWITCH" に変更．

情報: ネットリストよりコンポーネントとフットプリントをチェックしています "R25:/56CEA801:Resistors_SMD:R_0603"。

コンポーネントを "R25:/56CEA801" ピン "1" ネット名を， "N-0000051" から "Net-(D2-Pad2)" に変更．

コンポーネントを "R25:/56CEA801" ピン "2" ネット名を， "DGND" から "GNDA" に変更．

情報: ネットリストよりコンポーネントとフットプリントをチェックしています "R26:/5A3574D7:Resistors_SMD:R_0603"。

コンポーネントを "R26:/5A3574D7" ピン "1" ネット名を， "N-00000119" から "Net-(D3-Pad2)" に変更．

コンポーネントを "R26:/5A3574D7" ピン "2" ネット名を， "DGND" から "GNDA" に変更．

情報: ネットリストよりコンポーネントとフットプリントをチェックしています "R27:/57C29F42:Resistors_SMD:R_0603"。

コンポーネントを "R27:/57C29F42" ピン "1" ネット名を， "D5V" から "A+5V" に変更．

コンポーネントを "R27:/57C29F42" ピン "2" ネット名を， "N-0000099" から "Net-(J4-Pad1)" に変更．

情報: ネットリストよりコンポーネントとフットプリントをチェックしています "R28:/56CEA7F5:Resistors_SMD:R_1206"。

コンポーネントを "R28:/56CEA7F5" ピン "1" ネット名を， "N-0000050" から "Net-(D4-Pad2)" に変更．

コンポーネントを "R28:/56CEA7F5" ピン "2" ネット名を， "DGND" から "GNDA" に変更．

情報: ネットリストよりコンポーネントとフットプリントをチェックしています "R29:/56CF0F9B:Resistors_SMD:R_0603"。

コンポーネントを "R29:/56CF0F9B" ピン "1" ネット名を， "N-00000107" から "Net-(R29-Pad1)" に変更．

情報: ネットリストよりコンポーネントとフットプリントをチェックしています "R30:/5A358B9D:Resistors_SMD:R_0603"。

コンポーネントを "R30:/5A358B9D" ピン "1" ネット名を， "+3.3V" から "D+3.3V" に変更．

情報: ネットリストよりコンポーネントとフットプリントをチェックしています "R31:/5A358B97:Resistors_SMD:R_0603"。

コンポーネントを "R31:/5A358B97" ピン "1" ネット名を， "+3.3V" から "D+3.3V" に変更．

情報: ネットリストよりコンポーネントとフットプリントをチェックしています "R32:/5A8DAF9B:Resistors_SMD:R_0603"。

コンポーネント "R32:/5A35897C" の値を， "4k7" から "1k" に変更．

情報: コンポーネントのパス， "R32:/5A35897C" を "/5A8DAF9B" に変更．

コンポーネントを "R32:/5A8DAF9B" ピン "1" ネット名を， "X_LIMIT1" から "D+3.3V" に変更．

コンポーネントを "R32:/5A8DAF9B" ピン "2" ネット名を， "+3.3V" から "WATER_FLOW" に変更．

情報: ネットリストよりコンポーネントとフットプリントをチェックしています "R33:/5A990A22:Resistors_SMD:R_0603"。

コンポーネント "R33:/5A35899C" の値を， "4k7" から "10k" に変更．

情報: コンポーネントのパス， "R33:/5A35899C" を "/5A990A22" に変更．

コンポーネントを "R33:/5A990A22" ピン "1" ネット名を， "X_LIMIT2" から "A+3.3V" に変更．

コンポーネントを "R33:/5A990A22" ピン "2" ネット名を， "+3.3V" から "Net-(R33-Pad2)" に変更．

情報: ネットリストよりコンポーネントとフットプリントをチェックしています "R34:/5A990A2E:Resistors_SMD:R_0603"。

コンポーネント "R34:/5A3589BC" の値を， "4k7" から "100k" に変更．

情報: コンポーネントのパス， "R34:/5A3589BC" を "/5A990A2E" に変更．

コンポーネントを "R34:/5A990A2E" ピン "1" ネット名を， "Y_LIMIT1" から "A+3.3V" に変更．

コンポーネントを "R34:/5A990A2E" ピン "2" ネット名を， "+3.3V" から "Y_EN_A" に変更．

情報: ネットリストよりコンポーネントとフットプリントをチェックしています "R35:/5A990A16:Resistors_SMD:R_0603"。

コンポーネント "R35:/5A3589DC" の値を， "4k7" から "0R" に変更．

情報: コンポーネントのパス， "R35:/5A3589DC" を "/5A990A16" に変更．

コンポーネントを "R35:/5A990A16" ピン "1" ネット名を， "Y_LIMIT2" から "Net-(R35-Pad1)" に変更．

コンポーネントを "R35:/5A990A16" ピン "2" ネット名を， "+3.3V" から "GNDA" に変更．

情報: ネットリストよりコンポーネントとフットプリントをチェックしています "R36:/56CEA907:Resistors_SMD:R_0603"。

コンポーネント "R36:/56CEA907" の値を， "4k7" から "1k" に変更．

コンポーネントを "R36:/56CEA907" ピン "1" ネット名を， "D33V" から "A+3.3V" に変更．

コンポーネントを "R36:/56CEA907" ピン "2" ネット名を， "N-0000013" から "Net-(R36-Pad2)" に変更．

情報: ネットリストよりコンポーネントとフットプリントをチェックしています "R37:/5A990A04:Resistors_SMD:R_1206"。

コンポーネント "R37:/5A35765F" の値を， "4k7" から "0R1" に変更．

情報: コンポーネントのパス， "R37:/5A35765F" を "/5A990A04" に変更．

コンポーネントを "R37:/5A990A04" ピン "1" ネット名を， "D_SWITCH" から "Net-(R37-Pad1)" に変更．

コンポーネントを "R37:/5A990A04" ピン "2" ネット名を， "+3.3V" から "GNDA" に変更．

情報: ネットリストよりコンポーネントとフットプリントをチェックしています "R38:/56CEA901:Resistors_SMD:R_0603"。

コンポーネント "R38:/56CEA901" の値を， "4k7" から "1k" に変更．

コンポーネントを "R38:/56CEA901" ピン "1" ネット名を， "D33V" から "A+3.3V" に変更．

コンポーネントを "R38:/56CEA901" ピン "2" ネット名を， "N-0000042" から "Net-(R38-Pad2)" に変更．

情報: ネットリストよりコンポーネントとフットプリントをチェックしています "R39:/56CEA865:Resistors_SMD:R_0603"。

コンポーネントを "R39:/56CEA865" ピン "1" ネット名を， "D33V" から "A+3.3V" に変更．

コンポーネントを "R39:/56CEA865" ピン "2" ネット名を， "N-0000012" から "Net-(R39-Pad2)" に変更．

情報: ネットリストよりコンポーネントとフットプリントをチェックしています "R40:/5A990A0A:Resistors_SMD:R_1206"。

コンポーネント "R40:/5A354FEE" の値を， "4k7" から "0R1" に変更．

情報: コンポーネントのパス， "R40:/5A354FEE" を "/5A990A0A" に変更．

コンポーネントを "R40:/5A990A0A" ピン "1" ネット名を， "WATER_FLOW" から "Net-(R40-Pad1)" に変更．

コンポーネントを "R40:/5A990A0A" ピン "2" ネット名を， "+3.3V" から "GNDA" に変更．

情報: ネットリストよりコンポーネントとフットプリントをチェックしています "R41:/5AAA52C3:Resistors_SMD:R_1206"。

コンポーネント "R41:/5A358E68" の値を， "1k" から "0" に変更．

情報: コンポーネントのパス， "R41:/5A358E68" を "/5AAA52C3" に変更．

コンポーネントを "R41:/5AAA52C3" ピン "1" ネット名を， "N-0000046" から "GNDD" に変更．

コンポーネントを "R41:/5AAA52C3" ピン "2" ネット名を， "D12V" から "GNDA" に変更．

情報: ネットリストよりコンポーネントとフットプリントをチェックしています "R51:/5A354904:Resistors_SMD:R_1206"。

コンポーネントを "R51:/5A354904" ピン "1" ネット名を， "N-0000082" から "Net-(J6-Pad3)" に変更．

コンポーネントを "R51:/5A354904" ピン "2" ネット名を， "N-0000081" から "Net-(R51-Pad2)" に変更．

情報: ネットリストよりコンポーネントとフットプリントをチェックしています "R53:/5A353B44:Resistors_SMD:R_0603"。

コンポーネントを "R53:/5A353B44" ピン "1" ネット名を， "+3.3V" から "D+3.3V" に変更．

情報: ネットリストよりコンポーネントとフットプリントをチェックしています "R54:/5A353B3E:Resistors_SMD:R_0603"。

コンポーネントを "R54:/5A353B3E" ピン "1" ネット名を， "+3.3V" から "D+3.3V" に変更．

情報: ネットリストよりコンポーネントとフットプリントをチェックしています "R55:/5A35E2C9:Resistors_SMD:R_1206"。

コンポーネントを "R55:/5A35E2C9" ピン "1" ネット名を， "N-0000076" から "Net-(R55-Pad1)" に変更．

情報: ネットリストよりコンポーネントとフットプリントをチェックしています "R56:/5A35E2AC:Resistors_SMD:R_1206"。

コンポーネントを "R56:/5A35E2AC" ピン "1" ネット名を， "N-0000077" から "Net-(R56-Pad1)" に変更．

情報: ネットリストよりコンポーネントとフットプリントをチェックしています "R57:/5A35E2E6:Resistors_SMD:R_1206"。

コンポーネントを "R57:/5A35E2E6" ピン "1" ネット名を， "N-0000075" から "Net-(R57-Pad1)" に変更．

情報: ネットリストよりコンポーネントとフットプリントをチェックしています "R58:/5A35B737:Resistors_SMD:R_1206"。

コンポーネントを "R58:/5A35B737" ピン "1" ネット名を， "N-0000087" から "Net-(R58-Pad1)" に変更．

情報: ネットリストよりコンポーネントとフットプリントをチェックしています "R59:/5A35A047:Resistors_SMD:R_1206"。

コンポーネントを "R59:/5A35A047" ピン "1" ネット名を， "N-0000089" から "Net-(R59-Pad1)" に変更．

情報: ネットリストよりコンポーネントとフットプリントをチェックしています "R60:/5A35B754:Resistors_SMD:R_1206"。

コンポーネントを "R60:/5A35B754" ピン "1" ネット名を， "N-0000086" から "Net-(R60-Pad1)" に変更．

情報: ネットリストよりコンポーネントとフットプリントをチェックしています "R62:/5A3561C6:Resistors_SMD:R_0603"。

コンポーネントを "R62:/5A3561C6" ピン "1" ネット名を， "D33V" から "A+3.3V" に変更．

コンポーネントを "R62:/5A3561C6" ピン "2" ネット名を， "N-0000091" から "Net-(R62-Pad2)" に変更．

情報: ネットリストよりコンポーネントとフットプリントをチェックしています "R63:/5A3561C0:Resistors_SMD:R_0603"。

コンポーネントを "R63:/5A3561C0" ピン "1" ネット名を， "D33V" から "A+3.3V" に変更．

コンポーネントを "R63:/5A3561C0" ピン "2" ネット名を， "N-0000090" から "Net-(R63-Pad2)" に変更．

情報: ネットリストよりコンポーネントとフットプリントをチェックしています "R64:/57C2AC40:Resistors_SMD:R_0603"。

コンポーネントを "R64:/57C2AC40" ピン "1" ネット名を， "N-00000100" から "Net-(C33-Pad1)" に変更．

コンポーネントを "R64:/57C2AC40" ピン "2" ネット名を， "DGND" から "GNDA" に変更．

情報: ネットリストよりコンポーネントとフットプリントをチェックしています "R65:/57C2AC3A:Resistors_SMD:R_1206"。

コンポーネントを "R65:/57C2AC3A" ピン "1" ネット名を， "N-00000100" から "Net-(C33-Pad1)" に変更．

コンポーネントを "R65:/57C2AC3A" ピン "2" ネット名を， "D12V" から "A+12V" に変更．

情報: ネットリストよりコンポーネントとフットプリントをチェックしています "R66:/56CEA95C:Resistors_SMD:R_0603"。

コンポーネントを "R66:/56CEA95C" ピン "1" ネット名を， "D33V" から "A+3.3V" に変更．

コンポーネントを "R66:/56CEA95C" ピン "2" ネット名を， "N-0000073" から "Y_EN_A" に変更．

情報: ネットリストよりコンポーネントとフットプリントをチェックしています "R67:/56CEA944:Resistors_SMD:R_0603"。

コンポーネントを "R67:/56CEA944" ピン "1" ネット名を， "D33V" から "A+3.3V" に変更．

コンポーネントを "R67:/56CEA944" ピン "2" ネット名を， "N-0000057" から "Net-(R67-Pad2)" に変更．

情報: ネットリストよりコンポーネントとフットプリントをチェックしています "R68:/56CEA976:Resistors_SMD:R_0603"。

コンポーネントを "R68:/56CEA976" ピン "1" ネット名を， "D33V" から "A+3.3V" に変更．

コンポーネントを "R68:/56CEA976" ピン "2" ネット名を， "N-0000063" から "Net-(R68-Pad2)" に変更．

情報: ネットリストよりコンポーネントとフットプリントをチェックしています "R69:/56CEA98E:Resistors_SMD:R_0603"。

コンポーネントを "R69:/56CEA98E" ピン "1" ネット名を， "D33V" から "A+3.3V" に変更．

コンポーネントを "R69:/56CEA98E" ピン "2" ネット名を， "N-0000069" から "Net-(R69-Pad2)" に変更．

情報: ネットリストよりコンポーネントとフットプリントをチェックしています "R70:/56CEA938:Resistors_SMD:R_1206"。

コンポーネントを "R70:/56CEA938" ピン "1" ネット名を， "N-0000058" から "Net-(R70-Pad1)" に変更．

コンポーネントを "R70:/56CEA938" ピン "2" ネット名を， "DGND" から "GNDA" に変更．

情報: ネットリストよりコンポーネントとフットプリントをチェックしています "R71:/56CEA99A:Resistors_SMD:R_1206"。

コンポーネントを "R71:/56CEA99A" ピン "1" ネット名を， "N-0000068" から "Net-(R71-Pad1)" に変更．

コンポーネントを "R71:/56CEA99A" ピン "2" ネット名を， "DGND" から "GNDA" に変更．

情報: ネットリストよりコンポーネントとフットプリントをチェックしています "R73:/56CEA926:Resistors_SMD:R_1206"。

コンポーネントを "R73:/56CEA926" ピン "1" ネット名を， "N-0000060" から "Net-(R73-Pad1)" に変更．

コンポーネントを "R73:/56CEA926" ピン "2" ネット名を， "DGND" から "GNDA" に変更．

情報: ネットリストよりコンポーネントとフットプリントをチェックしています "R74:/56CEA9AC:Resistors_SMD:R_1206"。

コンポーネントを "R74:/56CEA9AC" ピン "1" ネット名を， "N-0000066" から "Net-(R74-Pad1)" に変更．

コンポーネントを "R74:/56CEA9AC" ピン "2" ネット名を， "DGND" から "GNDA" に変更．

情報: ネットリストよりコンポーネントとフットプリントをチェックしています "R75:/56CEA92C:Resistors_SMD:R_1206"。

コンポーネントを "R75:/56CEA92C" ピン "1" ネット名を， "N-0000059" から "Net-(R75-Pad1)" に変更．

コンポーネントを "R75:/56CEA92C" ピン "2" ネット名を， "DGND" から "GNDA" に変更．

情報: ネットリストよりコンポーネントとフットプリントをチェックしています "R76:/56CEA9A6:Resistors_SMD:R_1206"。

コンポーネントを "R76:/56CEA9A6" ピン "1" ネット名を， "N-0000067" から "Net-(R76-Pad1)" に変更．

コンポーネントを "R76:/56CEA9A6" ピン "2" ネット名を， "DGND" から "GNDA" に変更．

情報: ネットリストよりコンポーネントとフットプリントをチェックしています "SW1:/56CF02CF:mylib:DHT-1163S"。

コンポーネント "SW1:/56CF02CF" の値を， "SW_PUSH" から "DHT-1163S" に変更．

コンポーネントを "SW1:/56CF02CF" ピン "1" ネット名を， "GND" から "GNDD" に変更．

情報: ネットリストよりコンポーネントとフットプリントをチェックしています "SW2:/5726C615:mylib:SSSS213202"。

コンポーネント "SW2:/5726C615" の値を， "SWITCH_INV" から "SSSS213202" に変更．

コンポーネントを "SW2:/5726C615" ピン "3" ネット名を， "GND" から "GNDD" に変更．

コンポーネントを "SW2:/5726C615" ピン "2" ネット名を， "N-00000107" から "Net-(R29-Pad1)" に変更．

コンポーネントを "SW2:/5726C615" ピン "1" ネット名を， "+3.3V" から "D+3.3V" に変更．

情報: ネットリストよりコンポーネントとフットプリントをチェックしています "TP1:/5A92E5A4:Pin_Headers:Pin_Header_Straight_1x01_Pitch1.00mm"。

コンポーネント "TP1:/5A92E5A4" フットプリント "Pin_Headers:Pin_Header_Straight_1x01_Pitch1.00mm" を追加します。

コンポーネントを "TP1:/5A92E5A4" ピン "1" ネット名を， "" から "GNDA" に変更．

情報: ネットリストよりコンポーネントとフットプリントをチェックしています "TP2:/5A92F129:Pin_Headers:Pin_Header_Straight_1x01_Pitch1.00mm"。

コンポーネント "TP2:/5A92F129" フットプリント "Pin_Headers:Pin_Header_Straight_1x01_Pitch1.00mm" を追加します。

コンポーネントを "TP2:/5A92F129" ピン "1" ネット名を， "" から "GNDA" に変更．

情報: ネットリストよりコンポーネントとフットプリントをチェックしています "TP3:/5A92F363:Pin_Headers:Pin_Header_Straight_1x01_Pitch1.00mm"。

コンポーネント "TP3:/5A92F363" フットプリント "Pin_Headers:Pin_Header_Straight_1x01_Pitch1.00mm" を追加します。

コンポーネントを "TP3:/5A92F363" ピン "1" ネット名を， "" から "GNDA" に変更．

情報: ネットリストよりコンポーネントとフットプリントをチェックしています "TP4:/5A92F59C:Pin_Headers:Pin_Header_Straight_1x01_Pitch1.00mm"。

コンポーネント "TP4:/5A92F59C" フットプリント "Pin_Headers:Pin_Header_Straight_1x01_Pitch1.00mm" を追加します。

コンポーネントを "TP4:/5A92F59C" ピン "1" ネット名を， "" から "GNDD" に変更．

情報: ネットリストよりコンポーネントとフットプリントをチェックしています "U1:/5A34C012:mylib:LD1117S33TR"。

コンポーネントを "U1:/5A34C012" ピン "4" ネット名を， "D33V" から "A+3.3V" に変更．

コンポーネントを "U1:/5A34C012" ピン "2" ネット名を， "D33V" から "A+3.3V" に変更．

コンポーネントを "U1:/5A34C012" ピン "3" ネット名を， "N-00000129" から "A+12V" に変更．

コンポーネントを "U1:/5A34C012" ピン "1" ネット名を， "DGND" から "GNDA" に変更．

情報: ネットリストよりコンポーネントとフットプリントをチェックしています "U2:/56CFA735:mylib:LD1117S33TR"。

コンポーネントを "U2:/56CFA735" ピン "4" ネット名を， "+3.3V" から "D+3.3V" に変更．

コンポーネントを "U2:/56CFA735" ピン "2" ネット名を， "+3.3V" から "D+3.3V" に変更．

コンポーネントを "U2:/56CFA735" ピン "1" ネット名を， "GND" から "GNDD" に変更．

情報: ネットリストよりコンポーネントとフットプリントをチェックしています "U3:/56CEB14F:Housings_QFP:LQFP-64_10x10mm_Pitch0.5mm"。

コンポーネントを "U3:/56CEB14F" ピン "64" ネット名を， "+3.3V" から "D+3.3V" に変更．

コンポーネントを "U3:/56CEB14F" ピン "63" ネット名を， "GND" から "GNDD" に変更．

コンポーネントを "U3:/56CEB14F" ピン "62" ネット名を， "" から "Net-(U3-Pad62)" に変更．

コンポーネントを "U3:/56CEB14F" ピン "61" ネット名を， "" から "Net-(U3-Pad61)" に変更．

コンポーネントを "U3:/56CEB14F" ピン "57" ネット名を， "" から "Net-(U3-Pad57)" に変更．

コンポーネントを "U3:/56CEB14F" ピン "56" ネット名を， "" から "Net-(U3-Pad56)" に変更．

コンポーネントを "U3:/56CEB14F" ピン "54" ネット名を， "" から "Net-(U3-Pad54)" に変更．

コンポーネントを "U3:/56CEB14F" ピン "53" ネット名を， "" から "Net-(U3-Pad53)" に変更．

コンポーネントを "U3:/56CEB14F" ピン "52" ネット名を， "" から "Net-(U3-Pad52)" に変更．

コンポーネントを "U3:/56CEB14F" ピン "51" ネット名を， "" から "Net-(U3-Pad51)" に変更．

コンポーネントを "U3:/56CEB14F" ピン "18" ネット名を， "GND" から "GNDD" に変更．

コンポーネントを "U3:/56CEB14F" ピン "19" ネット名を， "+3.3V" から "D+3.3V" に変更．

コンポーネントを "U3:/56CEB14F" ピン "23" ネット名を， "" から "Net-(U3-Pad23)" に変更．

コンポーネントを "U3:/56CEB14F" ピン "26" ネット名を， "" から "Net-(U3-Pad26)" に変更．

コンポーネントを "U3:/56CEB14F" ピン "27" ネット名を， "" から "Net-(U3-Pad27)" に変更．

コンポーネントを "U3:/56CEB14F" ピン "28" ネット名を， "N-00000108" から "Net-(R1-Pad1)" に変更．

コンポーネントを "U3:/56CEB14F" ピン "29" ネット名を， "" から "Net-(U3-Pad29)" に変更．

コンポーネントを "U3:/56CEB14F" ピン "30" ネット名を， "" から "Net-(U3-Pad30)" に変更．

コンポーネントを "U3:/56CEB14F" ピン "31" ネット名を， "N-0000035" から "Net-(C9-Pad1)" に変更．

コンポーネントを "U3:/56CEB14F" ピン "32" ネット名を， "+3.3V" から "D+3.3V" に変更．

コンポーネントを "U3:/56CEB14F" ピン "14" ネット名を， "" から "Net-(U3-Pad14)" に変更．

コンポーネントを "U3:/56CEB14F" ピン "12" ネット名を， "GND" から "GNDD" に変更．

コンポーネントを "U3:/56CEB14F" ピン "11" ネット名を， "" から "Net-(U3-Pad11)" に変更．

コンポーネントを "U3:/56CEB14F" ピン "2" ネット名を， "" から "Net-(U3-Pad2)" に変更．

コンポーネントを "U3:/56CEB14F" ピン "48" ネット名を， "+3.3V" から "D+3.3V" に変更．

コンポーネントを "U3:/56CEB14F" ピン "47" ネット名を， "N-0000034" から "Net-(C10-Pad1)" に変更．

コンポーネントを "U3:/56CEB14F" ピン "43" ネット名を， "" から "Net-(U3-Pad43)" に変更．

コンポーネントを "U3:/56CEB14F" ピン "42" ネット名を， "" から "Net-(U3-Pad42)" に変更．

コンポーネントを "U3:/56CEB14F" ピン "38" ネット名を， "" から "Net-(U3-Pad38)" に変更．

コンポーネントを "U3:/56CEB14F" ピン "36" ネット名を， "" から "Net-(U3-Pad36)" に変更．

コンポーネントを "U3:/56CEB14F" ピン "35" ネット名を， "" から "Net-(U3-Pad35)" に変更．

コンポーネントを "U3:/56CEB14F" ピン "34" ネット名を， "" から "Net-(U3-Pad34)" に変更．

コンポーネントを "U3:/56CEB14F" ピン "1" ネット名を， "+3.3V" から "D+3.3V" に変更．

コンポーネントを "U3:/56CEB14F" ピン "17" ネット名を， "" から "Net-(U3-Pad17)" に変更．

情報: ネットリストよりコンポーネントとフットプリントをチェックしています "U4:/5A34C026:mylib:LD1117S33TR"。

コンポーネントを "U4:/5A34C026" ピン "4" ネット名を， "D5V" から "A+5V" に変更．

コンポーネントを "U4:/5A34C026" ピン "2" ネット名を， "D5V" から "A+5V" に変更．

コンポーネントを "U4:/5A34C026" ピン "3" ネット名を， "N-00000130" から "A+12V" に変更．

コンポーネントを "U4:/5A34C026" ピン "1" ネット名を， "DGND" から "GNDA" に変更．

情報: ネットリストよりコンポーネントとフットプリントをチェックしています "U5:/5A358BB0:Buttons_Switches_SMD:SW_SPST_Panasonic_EVQPL_3PL_5PL_PT_A15"。

コンポーネントを "U5:/5A358BB0" ピン "1" ネット名を， "+3.3V" から "D+3.3V" に変更．

コンポーネントを "U5:/5A358BB0" ピン "4" ネット名を， "GND" から "GNDD" に変更．

コンポーネントを "U5:/5A358BB0" ピン "5" ネット名を， "DGND" から "GNDA" に変更．

コンポーネントを "U5:/5A358BB0" ピン "6" ネット名を， "N-0000013" から "Net-(R36-Pad2)" に変更．

コンポーネントを "U5:/5A358BB0" ピン "7" ネット名を， "N-0000042" から "Net-(R38-Pad2)" に変更．

コンポーネントを "U5:/5A358BB0" ピン "8" ネット名を， "D33V" から "A+3.3V" に変更．

情報: ネットリストよりコンポーネントとフットプリントをチェックしています "U6:/5A9B8B34:mylib:TLP2355"。

コンポーネント "U6:/5A353AF5" の値を， "TLP627-4" から "TLP2355" に変更．

情報: コンポーネントのパス， "U6:/5A353AF5" を "/5A9B8B34" に変更．

コンポーネントを "U6:/5A9B8B34" ピン "1" ネット名を， "N-0000046" から "Net-(R6-Pad1)" に変更．

コンポーネントの "U6:/5A9B8B34" ピン "2" ネット名をクリア．

コンポーネントを "U6:/5A9B8B34" ピン "3" ネット名を， "N-0000047" から "GNDD" に変更．

コンポーネントを "U6:/5A9B8B34" ピン "4" ネット名を， "N-0000092" から "GNDA" に変更．

コンポーネントを "U6:/5A9B8B34" ピン "5" ネット名を， "N-0000048" から "Net-(J11-Pad1)" に変更．

コンポーネントを "U6:/5A9B8B34" ピン "6" ネット名を， "N-0000093" から "A+5V" に変更．

コンポーネントの "U6:/5A9B8B34" ピン "7" ネット名をクリア．

コンポーネントの "U6:/5A9B8B34" ピン "8" ネット名をクリア．

コンポーネントの "U6:/5A9B8B34" ピン "9" ネット名をクリア．

コンポーネントの "U6:/5A9B8B34" ピン "10" ネット名をクリア．

コンポーネントの "U6:/5A9B8B34" ピン "11" ネット名をクリア．

コンポーネントの "U6:/5A9B8B34" ピン "12" ネット名をクリア．

コンポーネントの "U6:/5A9B8B34" ピン "13" ネット名をクリア．

コンポーネントの "U6:/5A9B8B34" ピン "14" ネット名をクリア．

コンポーネントの "U6:/5A9B8B34" ピン "15" ネット名をクリア．

コンポーネントの "U6:/5A9B8B34" ピン "16" ネット名をクリア．

情報: ネットリストよりコンポーネントとフットプリントをチェックしています "U7:/5A7CD932:mylib:TLP2355"。

コンポーネント "U7:/5A355DD9" の値を， "TLP627" から "TLP2355" に変更．

情報: コンポーネントのパス， "U7:/5A355DD9" を "/5A7CD932" に変更．

コンポーネントを "U7:/5A7CD932" ピン "1" ネット名を， "N-0000080" から "Net-(R17-Pad2)" に変更．

コンポーネントの "U7:/5A7CD932" ピン "2" ネット名をクリア．

コンポーネントを "U7:/5A7CD932" ピン "3" ネット名を， "GND" から "Net-(D5-Pad2)" に変更．

コンポーネントを "U7:/5A7CD932" ピン "4" ネット名を， "D_SWITCH" から "GNDD" に変更．

情報: ネットリストよりコンポーネントとフットプリントをチェックしています "U8:/5A7CFAC5:mylib:TLP2355"。

コンポーネント "U8:/56CEA84C" の値を， "MCP44X1" から "TLP2355" に変更．

情報: コンポーネントのパス， "U8:/56CEA84C" を "/5A7CFAC5" に変更．

コンポーネントを "U8:/5A7CFAC5" ピン "5" ネット名を， "N-0000013" から "X_LIMIT2" に変更．

コンポーネントを "U8:/5A7CFAC5" ピン "6" ネット名を， "N-0000042" から "D+3.3V" に変更．

コンポーネントの "U8:/5A7CFAC5" ピン "7" ネット名をクリア．

コンポーネントの "U8:/5A7CFAC5" ピン "8" ネット名をクリア．

コンポーネントの "U8:/5A7CFAC5" ピン "2" ネット名をクリア．

コンポーネントを "U8:/5A7CFAC5" ピン "3" ネット名を， "DGND" から "Net-(D6-Pad2)" に変更．

コンポーネントを "U8:/5A7CFAC5" ピン "4" ネット名を， "DGND" から "GNDD" に変更．

コンポーネントの "U8:/5A7CFAC5" ピン "15" ネット名をクリア．

コンポーネントの "U8:/5A7CFAC5" ピン "16" ネット名をクリア．

コンポーネントの "U8:/5A7CFAC5" ピン "17" ネット名をクリア．

コンポーネントの "U8:/5A7CFAC5" ピン "9" ネット名をクリア．

コンポーネントを "U8:/5A7CFAC5" ピン "1" ネット名を， "N-0000012" から "Net-(R16-Pad2)" に変更．

コンポーネントの "U8:/5A7CFAC5" ピン "10" ネット名をクリア．

情報: ネットリストよりコンポーネントとフットプリントをチェックしています "U9:/5A7D011E:mylib:TLP2355"。

コンポーネント "U9:/5A353B04" の値を， "TLP627" から "TLP2355" に変更．

情報: コンポーネントのパス， "U9:/5A353B04" を "/5A7D011E" に変更．

コンポーネントを "U9:/5A7D011E" ピン "1" ネット名を， "N-0000081" から "Net-(R15-Pad2)" に変更．

コンポーネントの "U9:/5A7D011E" ピン "2" ネット名をクリア．

コンポーネントを "U9:/5A7D011E" ピン "3" ネット名を， "GND" から "Net-(D7-Pad2)" に変更．

コンポーネントを "U9:/5A7D011E" ピン "4" ネット名を， "WATER_FLOW" から "GNDD" に変更．

情報: ネットリストよりコンポーネントとフットプリントをチェックしています "U10:/5A7D0344:mylib:TLP2355"。

コンポーネント "U10:/57C28102" の値を， "74HC08A" から "TLP2355" に変更．

情報: コンポーネントのパス， "U10:/57C28102" を "/5A7D0344" に変更．

コンポーネントを "U10:/5A7D0344" ピン "4" ネット名を， "Y_LIMIT1" から "GNDD" に変更．

コンポーネントを "U10:/5A7D0344" ピン "6" ネット名を， "N-00000102" から "D+3.3V" に変更．

コンポーネントの "U10:/5A7D0344" ピン "7" ネット名をクリア．

コンポーネントの "U10:/5A7D0344" ピン "8" ネット名をクリア．

コンポーネントを "U10:/5A7D0344" ピン "1" ネット名を， "X_LIMIT1" から "Net-(R10-Pad2)" に変更．

コンポーネントの "U10:/5A7D0344" ピン "2" ネット名をクリア．

コンポーネントを "U10:/5A7D0344" ピン "3" ネット名を， "N-00000101" から "Net-(D8-Pad2)" に変更．

コンポーネントの "U10:/5A7D0344" ピン "9" ネット名をクリア．

コンポーネントの "U10:/5A7D0344" ピン "10" ネット名をクリア．

コンポーネントの "U10:/5A7D0344" ピン "14" ネット名をクリア．

情報: ネットリストよりコンポーネントとフットプリントをチェックしています "U11:/5A353B4A:mylib:ADUM1250"。

コンポーネントを "U11:/5A353B4A" ピン "1" ネット名を， "+3.3V" から "D+3.3V" に変更．

コンポーネントを "U11:/5A353B4A" ピン "4" ネット名を， "GND" から "GNDD" に変更．

コンポーネントを "U11:/5A353B4A" ピン "5" ネット名を， "DGND" から "GNDA" に変更．

コンポーネントを "U11:/5A353B4A" ピン "6" ネット名を， "N-0000091" から "Net-(R62-Pad2)" に変更．

コンポーネントを "U11:/5A353B4A" ピン "7" ネット名を， "N-0000090" から "Net-(R63-Pad2)" に変更．

コンポーネントを "U11:/5A353B4A" ピン "8" ネット名を， "D33V" から "A+3.3V" に変更．

情報: ネットリストよりコンポーネントとフットプリントをチェックしています "U12:/5A35E2C3:mylib:TLP2355"。

コンポーネントを "U12:/5A35E2C3" ピン "1" ネット名を， "N-0000076" から "Net-(R55-Pad1)" に変更．

コンポーネントを "U12:/5A35E2C3" ピン "3" ネット名を， "GND" から "GNDD" に変更．

コンポーネントを "U12:/5A35E2C3" ピン "4" ネット名を， "DGND" から "GNDA" に変更．

コンポーネントを "U12:/5A35E2C3" ピン "5" ネット名を， "N-0000064" から "Y_STEP_A" に変更．

コンポーネントを "U12:/5A35E2C3" ピン "6" ネット名を， "D33V" から "A+3.3V" に変更．

情報: ネットリストよりコンポーネントとフットプリントをチェックしています "U13:/5A35E2A6:mylib:TLP2355"。

コンポーネントを "U13:/5A35E2A6" ピン "1" ネット名を， "N-0000077" から "Net-(R56-Pad1)" に変更．

コンポーネントを "U13:/5A35E2A6" ピン "3" ネット名を， "GND" から "GNDD" に変更．

コンポーネントを "U13:/5A35E2A6" ピン "4" ネット名を， "DGND" から "GNDA" に変更．

コンポーネントを "U13:/5A35E2A6" ピン "5" ネット名を， "N-0000072" から "Y_DIR_A" に変更．

コンポーネントを "U13:/5A35E2A6" ピン "6" ネット名を， "D33V" から "A+3.3V" に変更．

情報: ネットリストよりコンポーネントとフットプリントをチェックしています "U14:/5A35E2E0:mylib:TLP2355"。

コンポーネントを "U14:/5A35E2E0" ピン "1" ネット名を， "N-0000075" から "Net-(R57-Pad1)" に変更．

コンポーネントを "U14:/5A35E2E0" ピン "3" ネット名を， "GND" から "GNDD" に変更．

コンポーネントを "U14:/5A35E2E0" ピン "4" ネット名を， "DGND" から "GNDA" に変更．

コンポーネントを "U14:/5A35E2E0" ピン "5" ネット名を， "N-0000073" から "Y_EN_A" に変更．

コンポーネントを "U14:/5A35E2E0" ピン "6" ネット名を， "D33V" から "A+3.3V" に変更．

情報: ネットリストよりコンポーネントとフットプリントをチェックしています "U15:/5A35B731:mylib:TLP2355"。

コンポーネントを "U15:/5A35B731" ピン "1" ネット名を， "N-0000087" から "Net-(R58-Pad1)" に変更．

コンポーネントを "U15:/5A35B731" ピン "3" ネット名を， "GND" から "GNDD" に変更．

コンポーネントを "U15:/5A35B731" ピン "4" ネット名を， "DGND" から "GNDA" に変更．

コンポーネントを "U15:/5A35B731" ピン "5" ネット名を， "N-0000041" から "Net-(U15-Pad5)" に変更．

コンポーネントを "U15:/5A35B731" ピン "6" ネット名を， "D33V" から "A+3.3V" に変更．

情報: ネットリストよりコンポーネントとフットプリントをチェックしています "U16:/5A35A041:mylib:TLP2355"。

コンポーネントを "U16:/5A35A041" ピン "1" ネット名を， "N-0000089" から "Net-(R59-Pad1)" に変更．

コンポーネントを "U16:/5A35A041" ピン "3" ネット名を， "GND" から "GNDD" に変更．

コンポーネントを "U16:/5A35A041" ピン "4" ネット名を， "DGND" から "GNDA" に変更．

コンポーネントを "U16:/5A35A041" ピン "5" ネット名を， "N-0000071" から "Net-(U16-Pad5)" に変更．

コンポーネントを "U16:/5A35A041" ピン "6" ネット名を， "D33V" から "A+3.3V" に変更．

情報: ネットリストよりコンポーネントとフットプリントをチェックしています "U17:/5A35B74E:mylib:TLP2355"。

コンポーネントを "U17:/5A35B74E" ピン "1" ネット名を， "N-0000086" から "Net-(R60-Pad1)" に変更．

コンポーネントを "U17:/5A35B74E" ピン "3" ネット名を， "GND" から "GNDD" に変更．

コンポーネントを "U17:/5A35B74E" ピン "4" ネット名を， "DGND" から "GNDA" に変更．

コンポーネントを "U17:/5A35B74E" ピン "5" ネット名を， "N-0000063" から "Net-(R68-Pad2)" に変更．

コンポーネントを "U17:/5A35B74E" ピン "6" ネット名を， "D33V" から "A+3.3V" に変更．

情報: ネットリストよりコンポーネントとフットプリントをチェックしています "U18:/5A8643E7:mylib:TLP2355"。

コンポーネント "U18:/56CEAC61" の値を， "74HC1G00" から "TLP2355" に変更．

情報: コンポーネントのパス， "U18:/56CEAC61" を "/5A8643E7" に変更．

コンポーネントを "U18:/5A8643E7" ピン "1" ネット名を， "N-00000109" から "Net-(R9-Pad2)" に変更．

コンポーネントの "U18:/5A8643E7" ピン "2" ネット名をクリア．

コンポーネントを "U18:/5A8643E7" ピン "3" ネット名を， "GND" から "Net-(D9-Pad2)" に変更．

コンポーネントを "U18:/5A8643E7" ピン "4" ネット名を， "N-000003" から "GNDD" に変更．

コンポーネントを "U18:/5A8643E7" ピン "5" ネット名を， "+3.3V" から "D_SWITCH" に変更．

情報: ネットリストよりコンポーネントとフットプリントをチェックしています "U19:/5A3541BE:mylib:MCP3425"。

コンポーネントを "U19:/5A3541BE" ピン "6" ネット名を， "DGND" から "GNDD" に変更．

コンポーネントを "U19:/5A3541BE" ピン "5" ネット名を， "D33V" から "A+3.3V" に変更．

コンポーネントを "U19:/5A3541BE" ピン "4" ネット名を， "N-0000090" から "Net-(R63-Pad2)" に変更．

コンポーネントを "U19:/5A3541BE" ピン "3" ネット名を， "N-0000091" から "Net-(R62-Pad2)" に変更．

コンポーネントを "U19:/5A3541BE" ピン "2" ネット名を， "DGND" から "GNDA" に変更．

コンポーネントを "U19:/5A3541BE" ピン "1" ネット名を， "N-00000100" から "Net-(C33-Pad1)" に変更．

情報: ネットリストよりコンポーネントとフットプリントをチェックしています "U20:/5865F65E:mylib:A4982SLPTR"。

コンポーネントを "U20:/5865F65E" ピン "6" ネット名を， "D33V" から "A+3.3V" に変更．

コンポーネントを "U20:/5865F65E" ピン "7" ネット名を， "N-0000057" から "Net-(R67-Pad2)" に変更．

コンポーネントを "U20:/5865F65E" ピン "8" ネット名を， "N-0000058" から "Net-(R70-Pad1)" に変更．

コンポーネントを "U20:/5865F65E" ピン "9" ネット名を， "N-0000057" から "Net-(R67-Pad2)" に変更．

コンポーネントを "U20:/5865F65E" ピン "22" ネット名を， "Y_MOT_2B" から "Y1_MOT_2B" に変更．

コンポーネントを "U20:/5865F65E" ピン "3" ネット名を， "N-0000056" から "Net-(C40-Pad1)" に変更．

コンポーネントを "U20:/5865F65E" ピン "4" ネット名を， "N-0000055" から "Net-(C32-Pad1)" に変更．

コンポーネントを "U20:/5865F65E" ピン "5" ネット名を， "D33V" から "A+3.3V" に変更．

コンポーネントを "U20:/5865F65E" ピン "15" ネット名を， "Y_MOT_1B" から "Y1_MOT_1B" に変更．

コンポーネントを "U20:/5865F65E" ピン "16" ネット名を， "D12V" から "A+12V" に変更．

コンポーネントを "U20:/5865F65E" ピン "17" ネット名を， "N-0000059" から "Net-(R75-Pad1)" に変更．

コンポーネントを "U20:/5865F65E" ピン "18" ネット名を， "Y_MOT_1A" から "Y1_MOT_1A" に変更．

コンポーネントを "U20:/5865F65E" ピン "19" ネット名を， "Y_MOT_2A" から "Y1_MOT_2A" に変更．

コンポーネントを "U20:/5865F65E" ピン "20" ネット名を， "N-0000060" から "Net-(R73-Pad1)" に変更．

コンポーネントを "U20:/5865F65E" ピン "10" ネット名を， "D33V" から "A+3.3V" に変更．

コンポーネントを "U20:/5865F65E" ピン "21" ネット名を， "D12V" から "A+12V" に変更．

コンポーネントを "U20:/5865F65E" ピン "2" ネット名を， "N-0000039" から "Net-(C44-Pad2)" に変更．

コンポーネントを "U20:/5865F65E" ピン "11" ネット名を， "N-0000064" から "Y_STEP_A" に変更．

コンポーネントを "U20:/5865F65E" ピン "14" ネット名を， "N-0000072" から "Y_DIR_A" に変更．

コンポーネントを "U20:/5865F65E" ピン "23" ネット名を， "N-0000073" から "Y_EN_A" に変更．

コンポーネントを "U20:/5865F65E" ピン "1" ネット名を， "N-0000040" から "Net-(C44-Pad1)" に変更．

コンポーネントを "U20:/5865F65E" ピン "13" ネット名を， "DGND" から "GNDA" に変更．

コンポーネントを "U20:/5865F65E" ピン "24" ネット名を， "DGND" から "GNDA" に変更．

コンポーネントを "U20:/5865F65E" ピン "25" ネット名を， "DGND" から "GNDA" に変更．

コンポーネントを "U20:/5865F65E" ピン "26" ネット名を， "DGND" から "GNDA" に変更．

情報: ネットリストよりコンポーネントとフットプリントをチェックしています "U21:/56CEA8D3:mylib:A4982SLPTR"。

コンポーネントを "U21:/56CEA8D3" ピン "6" ネット名を， "D33V" から "A+3.3V" に変更．

コンポーネントを "U21:/56CEA8D3" ピン "7" ネット名を， "N-0000069" から "Net-(R69-Pad2)" に変更．

コンポーネントを "U21:/56CEA8D3" ピン "8" ネット名を， "N-0000068" から "Net-(R71-Pad1)" に変更．

コンポーネントを "U21:/56CEA8D3" ピン "9" ネット名を， "N-0000069" から "Net-(R69-Pad2)" に変更．

コンポーネントを "U21:/56CEA8D3" ピン "3" ネット名を， "N-0000070" から "Net-(C41-Pad1)" に変更．

コンポーネントを "U21:/56CEA8D3" ピン "4" ネット名を， "N-0000065" から "Net-(C34-Pad1)" に変更．

コンポーネントを "U21:/56CEA8D3" ピン "5" ネット名を， "D33V" から "A+3.3V" に変更．

コンポーネントを "U21:/56CEA8D3" ピン "16" ネット名を， "D12V" から "A+12V" に変更．

コンポーネントを "U21:/56CEA8D3" ピン "17" ネット名を， "N-0000067" から "Net-(R76-Pad1)" に変更．

コンポーネントを "U21:/56CEA8D3" ピン "20" ネット名を， "N-0000066" から "Net-(R74-Pad1)" に変更．

コンポーネントを "U21:/56CEA8D3" ピン "10" ネット名を， "D33V" から "A+3.3V" に変更．

コンポーネントを "U21:/56CEA8D3" ピン "21" ネット名を， "D12V" から "A+12V" に変更．

コンポーネントを "U21:/56CEA8D3" ピン "2" ネット名を， "N-0000038" から "Net-(C45-Pad2)" に変更．

コンポーネントを "U21:/56CEA8D3" ピン "11" ネット名を， "N-0000041" から "Net-(U15-Pad5)" に変更．

コンポーネントを "U21:/56CEA8D3" ピン "14" ネット名を， "N-0000071" から "Net-(U16-Pad5)" に変更．

コンポーネントを "U21:/56CEA8D3" ピン "23" ネット名を， "N-0000063" から "Net-(R68-Pad2)" に変更．

コンポーネントを "U21:/56CEA8D3" ピン "1" ネット名を， "N-0000037" から "Net-(C45-Pad1)" に変更．

コンポーネントを "U21:/56CEA8D3" ピン "13" ネット名を， "DGND" から "GNDA" に変更．

コンポーネントを "U21:/56CEA8D3" ピン "24" ネット名を， "DGND" から "GNDA" に変更．

コンポーネントを "U21:/56CEA8D3" ピン "25" ネット名を， "DGND" から "GNDA" に変更．

コンポーネントを "U21:/56CEA8D3" ピン "26" ネット名を， "DGND" から "GNDA" に変更．

情報: ネットリストよりコンポーネントとフットプリントをチェックしています "U22:/5A8C641F:mylib:TLP2355"。

情報: コンポーネントのパス， "U22:/58805901" を "/5A8C641F" に変更．

コンポーネントを "U22:/5A8C641F" ピン "1" ネット名を， "N-00000103" から "Net-(R51-Pad2)" に変更．

コンポーネントを "U22:/5A8C641F" ピン "3" ネット名を， "GND" から "GNDA" に変更．

コンポーネントを "U22:/5A8C641F" ピン "4" ネット名を， "DGND" から "GNDD" に変更．

コンポーネントを "U22:/5A8C641F" ピン "5" ネット名を， "N-00000114" から "WATER_FLOW" に変更．

コンポーネントを "U22:/5A8C641F" ピン "6" ネット名を， "D5V" から "D+3.3V" に変更．

情報: ネットリストよりコンポーネントとフットプリントをチェックしています "U23:/5A7BBB36:TO_SOT_Packages_SMD:SOT-23-6"。

コンポーネント "U23:/5A7BBB36" フットプリント "TO_SOT_Packages_SMD:SOT-23-6" を追加します。

コンポーネントを "U23:/5A7BBB36" ピン "1" ネット名を， "" から "A+3.3V" に変更．

コンポーネントを "U23:/5A7BBB36" ピン "2" ネット名を， "" から "GNDA" に変更．

コンポーネントを "U23:/5A7BBB36" ピン "3" ネット名を， "" から "Net-(R36-Pad2)" に変更．

コンポーネントを "U23:/5A7BBB36" ピン "4" ネット名を， "" から "Net-(R38-Pad2)" に変更．

コンポーネントを "U23:/5A7BBB36" ピン "6" ネット名を， "" から "Net-(R39-Pad2)" に変更．

コンポーネントを "U23:/5A7BBB36" ピン "5" ネット名を， "" から "X_REF" に変更．

情報: ネットリストよりコンポーネントとフットプリントをチェックしています "U24:/5A7BF7E6:TO_SOT_Packages_SMD:SOT-23-6"。

コンポーネント "U24:/5A7BF7E6" フットプリント "TO_SOT_Packages_SMD:SOT-23-6" を追加します。

コンポーネントを "U24:/5A7BF7E6" ピン "1" ネット名を， "" から "A+3.3V" に変更．

コンポーネントを "U24:/5A7BF7E6" ピン "2" ネット名を， "" から "GNDA" に変更．

コンポーネントを "U24:/5A7BF7E6" ピン "3" ネット名を， "" から "Net-(R36-Pad2)" に変更．

コンポーネントを "U24:/5A7BF7E6" ピン "4" ネット名を， "" から "Net-(R38-Pad2)" に変更．

コンポーネントを "U24:/5A7BF7E6" ピン "6" ネット名を， "" から "Net-(R39-Pad2)" に変更．

コンポーネントを "U24:/5A7BF7E6" ピン "5" ネット名を， "" から "Y_REF" に変更．

情報: ネットリストよりコンポーネントとフットプリントをチェックしています "U25:/5A990A34:mylib:A4982SLPTR"。

コンポーネント "U25:/5A990A34" フットプリント "mylib:A4982SLPTR" を追加します。

コンポーネントを "U25:/5A990A34" ピン "1" ネット名を， "" から "Net-(C55-Pad1)" に変更．

コンポーネントを "U25:/5A990A34" ピン "2" ネット名を， "" から "Net-(C55-Pad2)" に変更．

コンポーネントを "U25:/5A990A34" ピン "3" ネット名を， "" から "Net-(C53-Pad1)" に変更．

コンポーネントを "U25:/5A990A34" ピン "4" ネット名を， "" から "Net-(C50-Pad1)" に変更．

コンポーネントを "U25:/5A990A34" ピン "5" ネット名を， "" から "A+3.3V" に変更．

コンポーネントを "U25:/5A990A34" ピン "6" ネット名を， "" から "A+3.3V" に変更．

コンポーネントを "U25:/5A990A34" ピン "7" ネット名を， "" から "Net-(R33-Pad2)" に変更．

コンポーネントを "U25:/5A990A34" ピン "8" ネット名を， "" から "Net-(R35-Pad1)" に変更．

コンポーネントを "U25:/5A990A34" ピン "9" ネット名を， "" から "Net-(R33-Pad2)" に変更．

コンポーネントを "U25:/5A990A34" ピン "10" ネット名を， "" から "A+3.3V" に変更．

コンポーネントを "U25:/5A990A34" ピン "11" ネット名を， "" から "Y_STEP_A" に変更．

コンポーネントを "U25:/5A990A34" ピン "12" ネット名を， "" から "Y_REF" に変更．

コンポーネントを "U25:/5A990A34" ピン "13" ネット名を， "" から "GNDA" に変更．

コンポーネントを "U25:/5A990A34" ピン "14" ネット名を， "" から "Y_DIR_A" に変更．

コンポーネントを "U25:/5A990A34" ピン "15" ネット名を， "" から "Y2_MOT_1B" に変更．

コンポーネントを "U25:/5A990A34" ピン "16" ネット名を， "" から "A+12V" に変更．

コンポーネントを "U25:/5A990A34" ピン "17" ネット名を， "" から "Net-(R40-Pad1)" に変更．

コンポーネントを "U25:/5A990A34" ピン "18" ネット名を， "" から "Y2_MOT_1A" に変更．

コンポーネントを "U25:/5A990A34" ピン "19" ネット名を， "" から "Y2_MOT_2A" に変更．

コンポーネントを "U25:/5A990A34" ピン "20" ネット名を， "" から "Net-(R37-Pad1)" に変更．

コンポーネントを "U25:/5A990A34" ピン "21" ネット名を， "" から "A+12V" に変更．

コンポーネントを "U25:/5A990A34" ピン "22" ネット名を， "" から "Y2_MOT_2B" に変更．

コンポーネントを "U25:/5A990A34" ピン "23" ネット名を， "" から "Y_EN_A" に変更．

コンポーネントを "U25:/5A990A34" ピン "24" ネット名を， "" から "GNDA" に変更．

情報: ネットリストよりコンポーネントとフットプリントをチェックしています "VR1:/57BEC6D7:Capacitors_SMD:C_0603"。

コンポーネントを "VR1:/57BEC6D7" ピン "1" ネット名を， "N-00000115" から "GNDD" に変更．

コンポーネントを "VR1:/57BEC6D7" ピン "2" ネット名を， "N-00000117" から "Net-(J2-Pad3)" に変更．

情報: ネットリストよりコンポーネントとフットプリントをチェックしています "VR2:/57BEC78C:Capacitors_SMD:C_0603"。

コンポーネントを "VR2:/57BEC78C" ピン "1" ネット名を， "N-00000115" から "GNDD" に変更．

コンポーネントを "VR2:/57BEC78C" ピン "2" ネット名を， "N-00000116" から "Net-(J2-Pad2)" に変更．

情報: ネットリストよりコンポーネントとフットプリントをチェックしています "X1:/56CEC198:Oscillators:Oscillator_SMD_Fordahl_DFAS15-4pin_5.0x3.2mm"。

コンポーネント "X1:/56CEC198" の値を， "CRYSTAL_4PIN" から "7B-25.000MAAJ-T" に変更．

コンポーネントを "X1:/56CEC198" ピン "2" ネット名を， "GND" から "GNDD" に変更．

コンポーネントを "X1:/56CEC198" ピン "4" ネット名を， "GND" から "GNDD" に変更．

情報: ネットリストよりコンポーネントとフットプリントをチェックしています "X2:/56CEB1AD:Capacitors_SMD:C_1206"。

コンポーネント "X2:/56CEB1AD" の値を， "CRYSTAL" から "9HT10-32.768KDZY-T" に変更．

エラー:コンポーネント 'J5' のパッド '3' がフットプリント 'B2B-XH-A' に見つかりませんでした.

エラー:コンポーネント 'J7' のパッド '3' がフットプリント 'B2B-XH-A' に見つかりませんでした.

エラー:コンポーネント 'J8' のパッド '3' がフットプリント 'B2B-XH-A' に見つかりませんでした.

エラー:コンポーネント 'J9' のパッド '3' がフットプリント 'B2B-XH-A' に見つかりませんでした.

エラー:コンポーネント 'J10' のパッド '3' がフットプリント 'B2B-XH-A' に見つかりませんでした.

エラー:コンポーネント 'L1' のパッド '3' がフットプリント 'C_0805' に見つかりませんでした.

エラー:コンポーネント 'L1' のパッド '4' がフットプリント 'C_0805' に見つかりませんでした.

エラー:コンポーネント 'U7' のパッド '5' がフットプリント 'TLP627' に見つかりませんでした.

エラー:コンポーネント 'U7' のパッド '6' がフットプリント 'TLP627' に見つかりませんでした.

エラー:コンポーネント 'U9' のパッド '5' がフットプリント 'TLP627' に見つかりませんでした.

エラー:コンポーネント 'U9' のパッド '6' がフットプリント 'TLP627' に見つかりませんでした.

エラー:コンポーネント 'U18' のパッド '6' がフットプリント 'TSOP-5' に見つかりませんでした.

エラー:コンポーネント 'U25' のパッド '25' がフットプリント 'mylib:A4982SLPTR' に見つかりませんでした.

エラー:コンポーネント 'U25' のパッド '26' がフットプリント 'mylib:A4982SLPTR' に見つかりませんでした.

警告: 導体ゾーン(ネット名 'D5V' )：ネットがパッドへ接続されていません.
警告: 導体ゾーン(ネット名 'D5V' )：ネットがパッドへ接続されていません.
警告: 導体ゾーン(ネット名 '+3.3V' )：ネットがパッドへ接続されていません.
警告: 導体ゾーン(ネット名 '+3.3V' )：ネットがパッドへ接続されていません.
