icprog/FaboolDSPcba/仕様検討/20180203_波形/フォトカプラ入力(パルス拡大).PNG

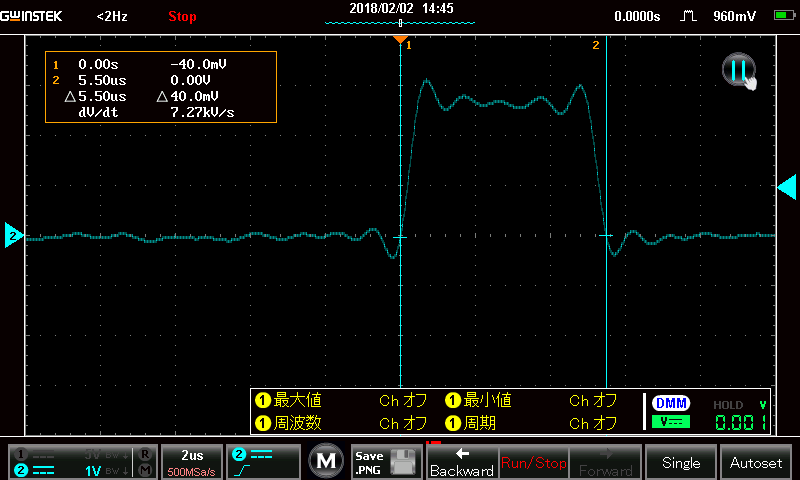
仕様検討/20180203_波形/フォトカプラ入力(パルス拡大).PNG
