icprog/FaboolDSPcba/仕様検討/20180203_波形/フォトカプラ入力.PNG

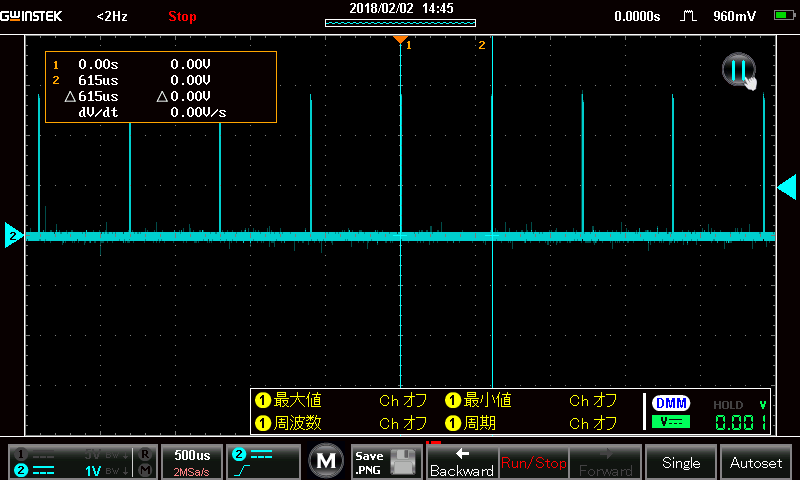
仕様検討/20180203_波形/フォトカプラ入力.PNG
