icprog/FaboolDSPcba/仕様検討/20180203_波形/モーター出力_新基板.PNG

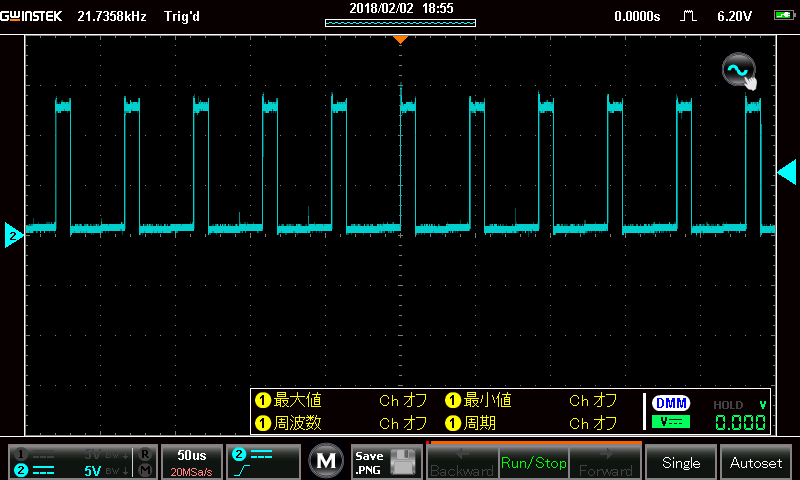
仕様検討/20180203_波形/モーター出力_新基板.PNG
