icprog/FaboolDSPcba/BOM/LaserDSBoard BOM_20181025.xlsx

Sheet: BOM
Part / Value | Package | Manufacturer | Part No | Circuit Reference | Qty | URL
Ceramic Capacitor
0u1, Ceramic, 16V, 10% | 0805 | Any | Any | C23,C12,C14,C17,C18,C19,C21,C22,C24,C25,C26,C27,C28,C30,C31,C33,C35,C36,C39,C40,C41,C44,C45,C46,C47,C48,C49,C51,C53,C55,C56 | 31
0u22, Ceramic, 10V, 10% | 0603 | Any | Any | C32,C34,C42,C43,C50,C54 | 6
10p, Ceramic, 10V, 10% | 0603 | Any | Any | C20,C15 | 2
20p, Ceramic, 10V, 10% | 0603 | Any | Any | C13,C11 | 2
1u, Ceramic, 16V, 10% | 0603 | Any | Any | C3 | 1
10u, Ceramic, 10V, 10% | 0805 | Any | Any | C1,C16,C2,C4,C6,C7,C8 | 7
2u2, Ceramic, 10V, 10% | 0603 | Any | Any | C10,C9 | 2
Aluminum Capacitor
100u, 35V, 20% | 6.3 x 7.7mm | Any | Any | C5,C38,C37,C52 | 4 | http://www.digikey.jp/product-detail/ja/UWT1V101MCL1GS/493-2203-1-ND/590178
XTAL
25MHz | 5032 | TXC CORPORATION | 7B-25.000MAAJ-T | X1 | 1 | https://www.digikey.jp/product-detail/ja/txc-corporation/7B-25.000MAAJ-T/887-1112-1-ND/2118989
32.768khz | 3.20mm x 1.50mm | TXC CORPORATION | 9HT10-32.768KDZY-T | X2 | 1 | https://www.digikey.jp/product-detail/ja/txc-corporation/9HT10-32.768KDZY-T/887-1506-1-ND/2690374
ESD
VARISTOR 0603 | 0603 | Bourns Inc. | CG0603MLC-05E | VR1,VR2 | 2 | http://www.digikey.jp/product-detail/ja/bourns-inc/CG0603MLC-05E/CG0603MLC-05ETR-ND/2538084
LED
2V, 3mA, Red | 0805 | Any | Any | D1,D5,D6,D7,D8,D9 | 6
2V, 3mA, Green | 0805 | Any | Any | D4 | 1
2V, 3mA, Blue | 0805 | Any | Any | D2,D10 | 2
2V, 3mA, Yellow | 0805 | Any | Any | D3 | 1
Connector
USB Type B Connector | USB - B | Any | Any | J2 | 1 | http://www.digikey.jp/product-detail/ja/on-shore-technology-inc/USB-B1HSW6/ED2982-ND/2677743
2P Connector |  | JST Sales America Inc | B2B-XH-A | J4,J5,J7,J8,J9,J10 | 6 | http://www.jst-mfg.com/product/detail.php?series=277
3P Connector |  | JST Sales America Inc | B3B-XH-A | J6,J11, | 2
4P Connector |  | JST Sales America Inc | B4P-VH | J3,J14,J15,J16 | 4 | http://www.jst-mfg.com/product/pdf/jpn/VH.pdf
Ferrite bead
35db@100k-1GHz | 12.1 x 9.1mm | murata | BNX024H01 | L1 | 1 | https://www.murata.com/ja-jp/products/productdetail?partno=BNX024H01%23
220Ω@100MHz, 700mA | 0603 | Laird-Signal Integrity Products | LI0603G221R-10 | L4 | 1 | http://www.digikey.jp/product-detail/ja/LI0603G221R-10/240-2368-1-ND/806728
Resistor
0R, 1/10W | 1206 | Any | Any | R35,R70,R71 | 4
0R1, 1W, 5% | 1206 | Panasonic | ERJB2CJR10V | R37,R40,R73,R74,R75,R76 | 6 | https://industrial.panasonic.com/jp/products/resistors/chip-resistors/current-sensing-chip-resistors/high-power-current-sensing-resistors-wide-terminal-type/E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
100k, 1/10W, 5% | 0603 | Any | Any | R34,R68,R66 | 3
10k, 1/10W, 5% | 0603 | Any | Any | R1,R11,R12,R13,R14,R29,R33,R67,R69,R18 | 10
1k, 1/10W, 5% | 0603 | Any | Any | R9,R10,R15,R16,R17,R36,R38 | 7
1k5, 1/10W, 5% | 0603 | Any | Any | R28,R4 | 2
1k2, 1/10W, 5% | 1206 | Any | Any | R51 | 1
220R, 1/4W, 5% | 1206 | Any | Any | R55,R56,R57,R58,R59,R6,R60,R43,R44,R45 | 10
22R, 1/10W, 5% | 0603 | Any | Any | R21,R22 | 2
2k4, 1/10W, 5% | 0603 | Any | Any | R65 | 1
2k7, 1/10W, 5% | 0603 | Any | Any | R39 | 1
390R, 1/10W, 5% | 0603 | Any | Any | R64 | 1
470R, 1/10W, 5% | 0603 | Any | Any | R26,R42 | 2
47R, 1/10W, 5% | 0603 | Any | Any | R27 | 1
4k7, 1/10W, 5% | 0603 | Any | Any | R2,R25,R3,R30,R31,R5,R53,R54,R62,R63,R7,R8 | 12
IC
Tact Switch |  | D.O Electronics Co.,Ltd | DHT-1163S | SW1 | 1 | http://www.seeedstudio.com/depot/images/opl/datasheet/311020029.pdf
Slide Switch |  | ALPS | SSSS213202 | SW2 | 1 | http://akizukidenshi.com/download/ds/alps/SSSS2_series.pdf
Motor Driver | 24-TSSOP | Allegro MicroSystems, LLC | A4982SLPTR | U21,U20,U25 | 3 | http://www.digikey.jp/product-detail/ja/allegro-microsystems-llc/A4982SLPTR-T/620-1352-2-ND/2295512
Isolator | 8-SOIC | Analog Devices Inc. | ADUM1250 | U5,U11 | 2 | http://www.analog.com/jp/products/interface-isolation/isolation/isolated-i2c-isolators/adum1250.html
LDO | SOT-223 | STMicroelectronics | LD1117S33TR | U2,U1 | 2 | https://www.digikey.jp/product-detail/ja/stmicroelectronics/LD1117S33TR/497-1242-2-ND/585766
LDO | SOT-223 | STMicroelectronics | LD1117S50TR | U4 | 1 | https://www.digikey.jp/product-detail/ja/stmicroelectronics/LD1117S50TR/497-6447-2-ND/1038360
ADC | SOT-23-6 | Microchip Technology | MCP3425A0T-E/CH | U19 | 1 | https://www.digikey.jp/product-detail/ja/microchip-technology/MCP3425A0T-E-CH/MCP3425A0T-E-CHCT-ND/1979810
Micon | 64-LQFP | STMicroelectronics | STM32F205RBT6 | U3 | 1 | http://www.digikey.jp/product-search/ja?keywords=STM32F205RBT6
Photo coupler | SO6 | TOSHIBA | TLP2355 | U10,U12,U13,U15,U16,U18,U22,U6,U7,U8,U9,U27,U28 | 13 | http://www.mouser.jp/ProductDetail/Toshiba/TLP2355TPLE/?qs=WTEd434rUSVWPmGECKBFzA%3D%3D
Photo coupler | SO6 | TOSHIBA | TLP291(SE | U14,U17,U29 | 3 | https://toshiba.semicon-storage.com/jp/product/opto/photocoupler/detail.TLP291(SE.html
Digital Potentiometer | SC70 | Microchip Technology | MCP4461 | U23 | 1 | http://ww1.microchip.com/downloads/en/DeviceDoc/22265a.pdf
Other
Heat Sink |  | Shenzhen S-mart Electronics Co.,Ltd | Heatsink 8.8*8.8*5mm with 3m thermal conductivity double-sided tape |  | 3

Sheet: 変更履歴
版数 | 変更内容
20180507 | U24,U26,C29,C57 削除 U23型番変更(TPL0401B→CCP4461) U24,U26削除
20180519 | R51 乗数変更 220R → 160R
20180607 | R51 乗数変更 160R → 1k2
20181025 | R41 削除(未実装)
