icprog/FaboolDSPcba/LaserDSBoard/LaserDSBoard.pdf

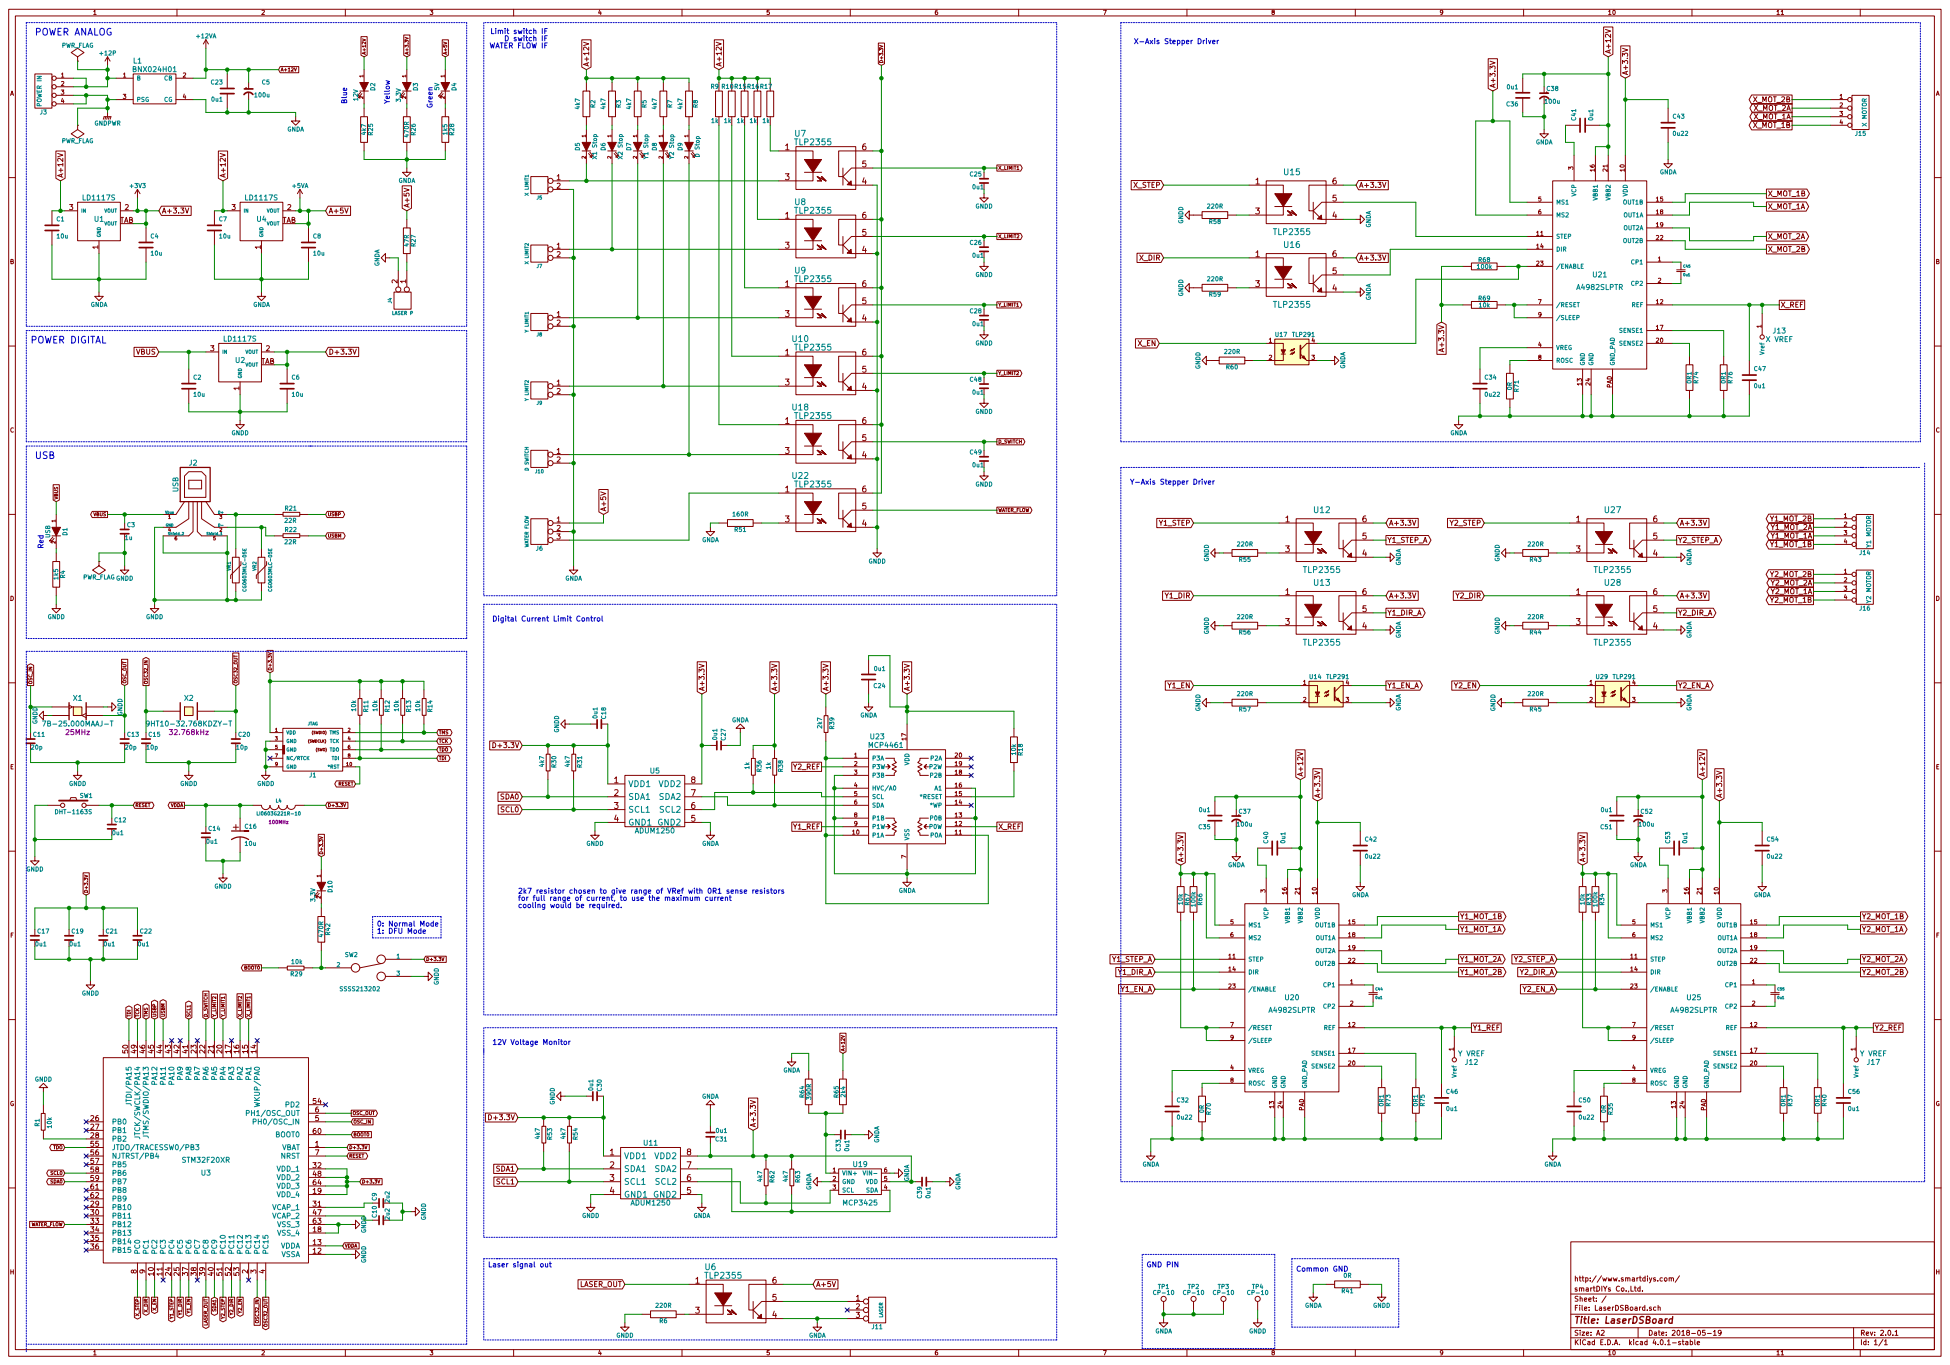
[picture p4: page 1]

Limit switch IF D switch IF WATER FLOW IF
TLP2355 A+12V R10

USBP USBM TCK TMS USBP USBM

Digital Current Limit Control

2k7 resistor chosen to give range of VRef with 0R1 sense resistors
for full range of current, to use the maximum current

File: LaserDSBoard.sch Sheet: / smartDIYs Co.,Ltd.
