icprog/FaboolDSPcba/Pcbscale.pdf

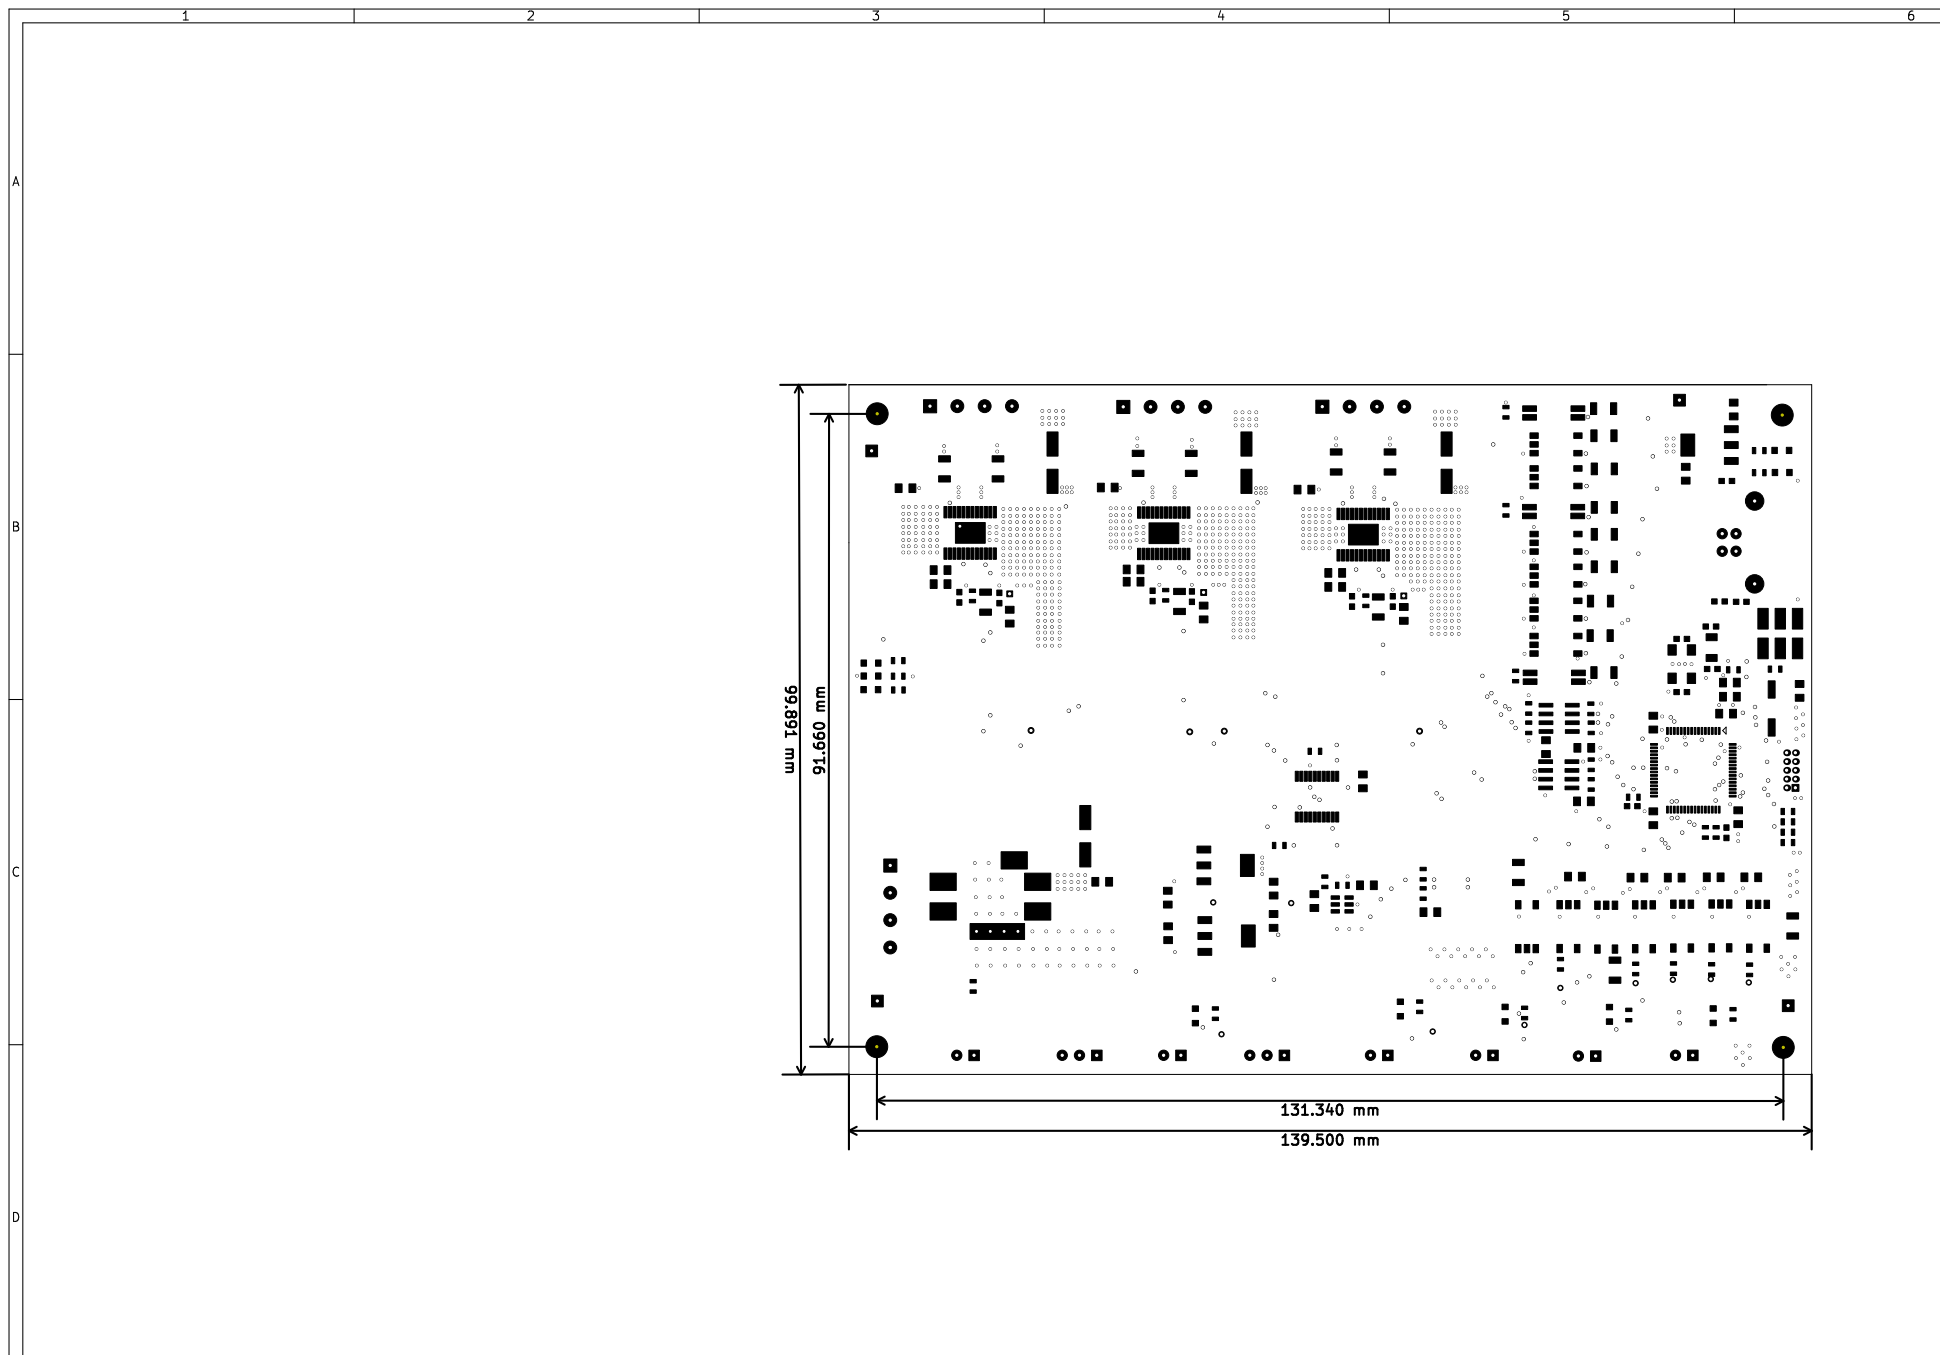
[picture p5: page 1]
