icprog/FaboolDSPcba/(list of files, drawings)

Other design files:
LaserDSBoard/LaserDSBoard.dsn
LaserDSBoard/LaserDSBoard_20180215.dsn
