icprog/FaboolDSPcba/LaserDSBoard/LaserDSBoard.kicad_pcb

## KiCad design LaserDSBoard/LaserDSBoard.kicad_pcb (2018-06-04)

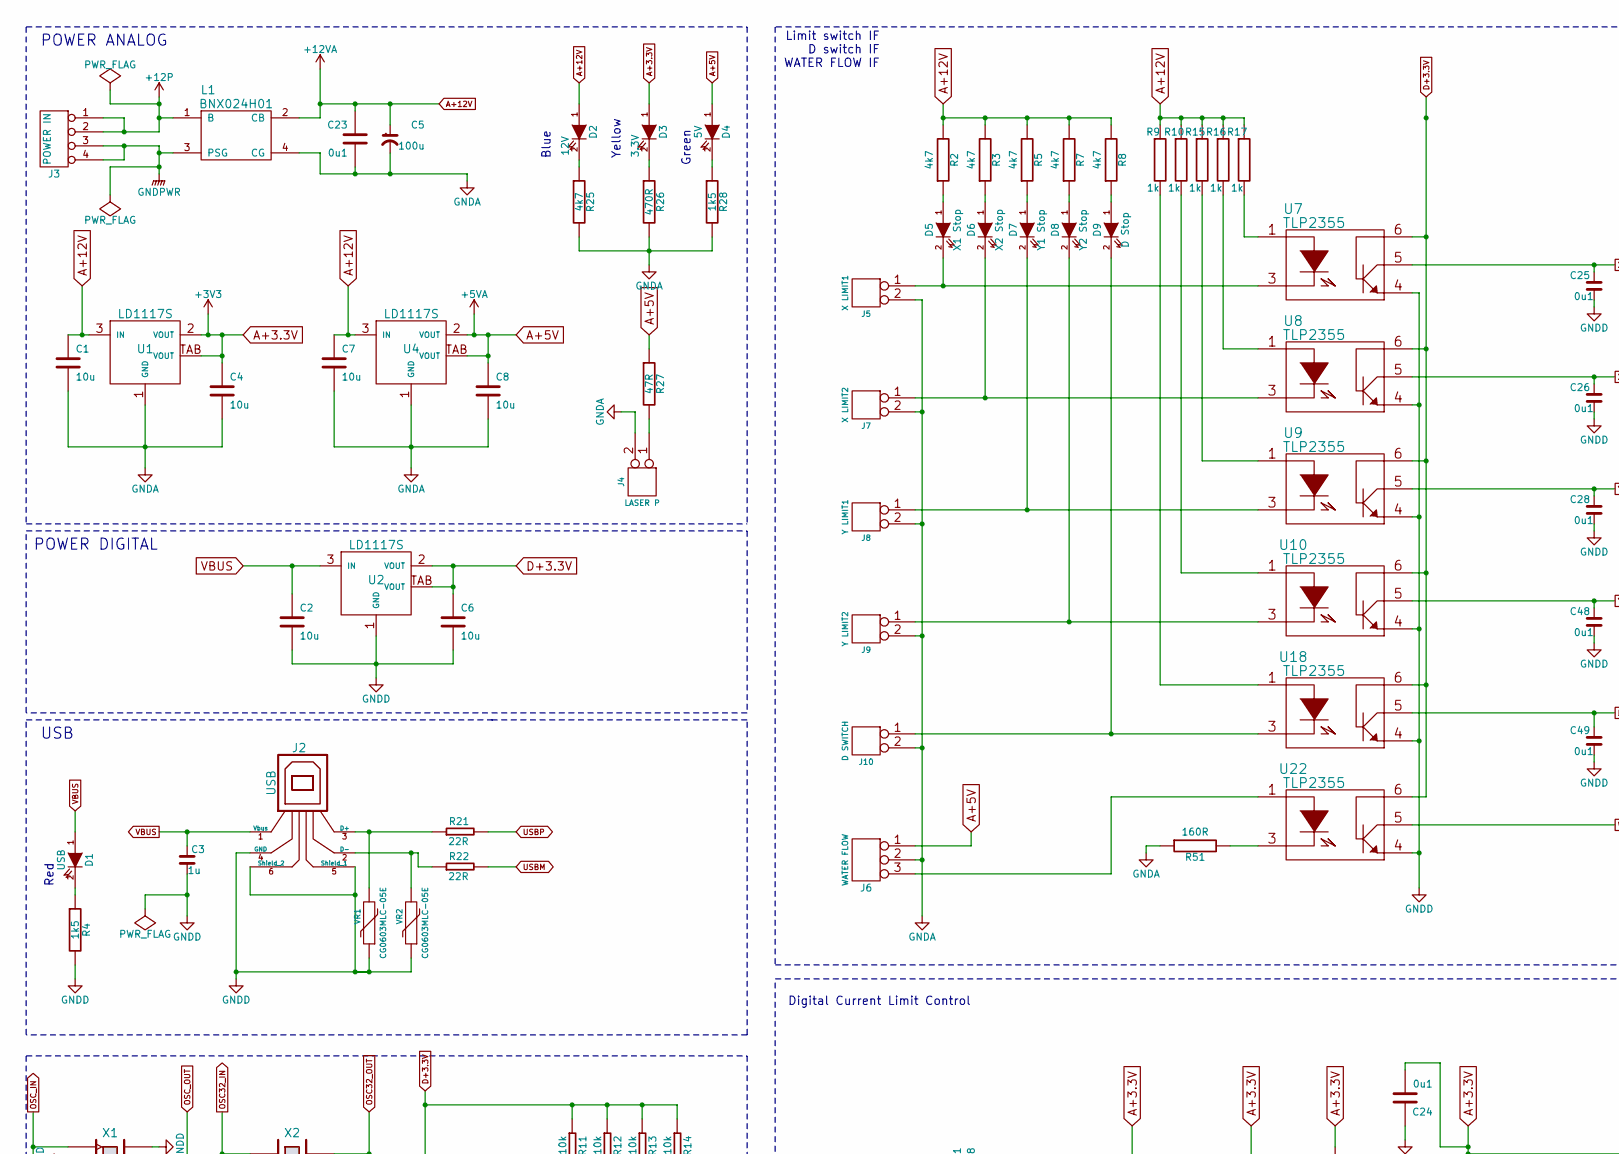
[picture p6: schematic LaserDSBoard.sch, part in row 1, column 1]

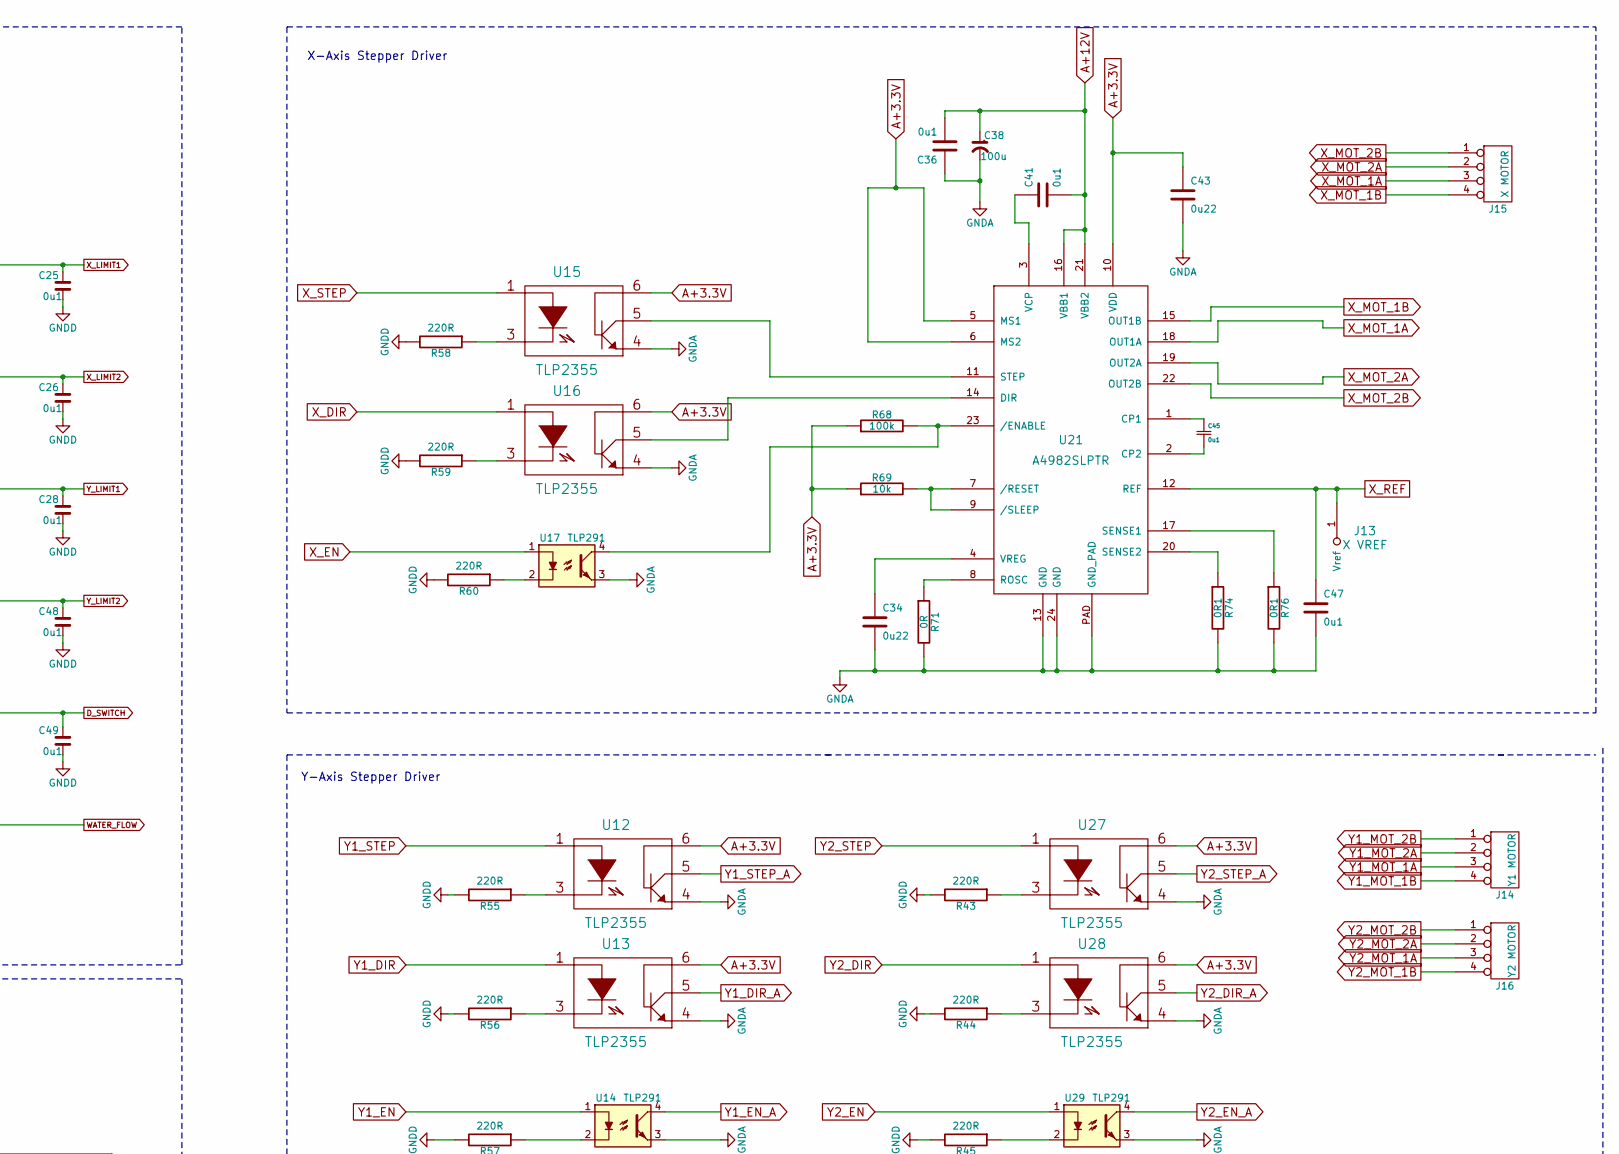
[picture p7: schematic LaserDSBoard.sch, part in row 1, column 2]

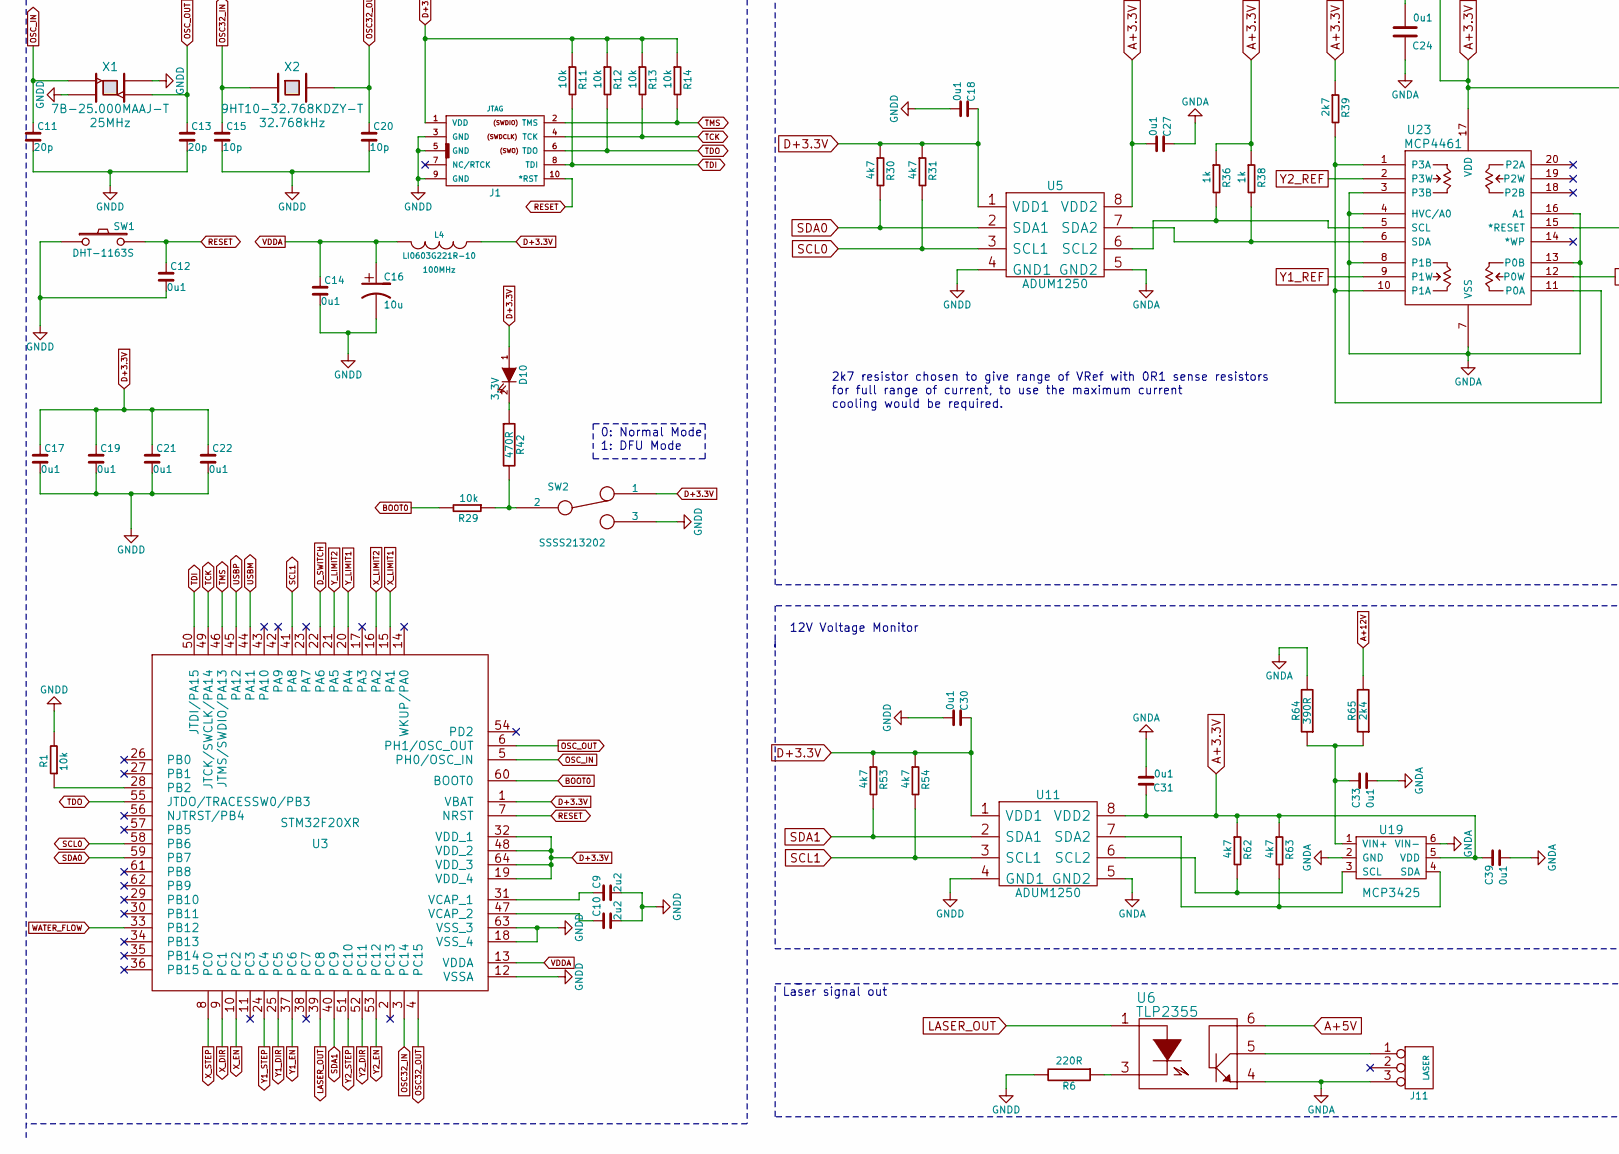
[picture p8: schematic LaserDSBoard.sch, part in row 2, column 1]

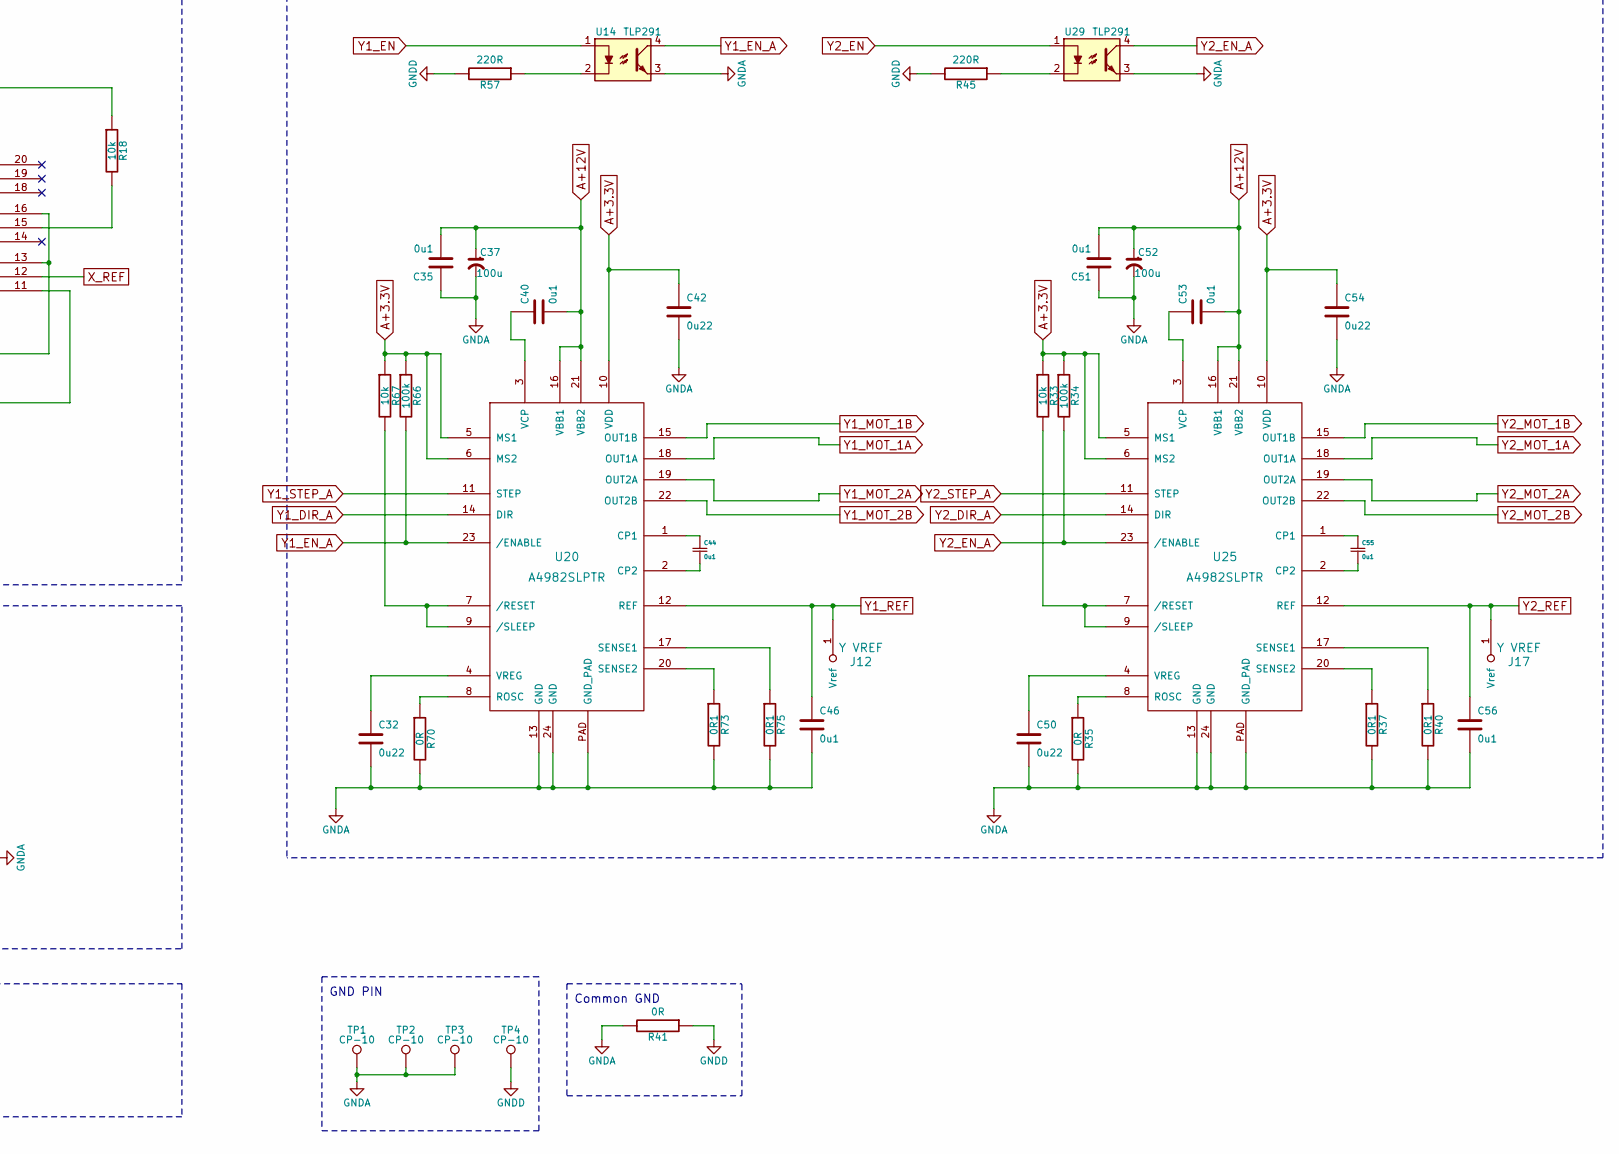
[picture p9: schematic LaserDSBoard.sch, part in row 2, column 2]

Parts:
C1, C2, C4, C6, C7, C8, C16: 10u; C_0805
C3: 1u; C_0603
C5, C37, C38, C52: 100u; CP_Elec_6.3x7.7
C9, C10: 2u2; C_0603
C11, C13: 20p; C_0603
C12, C14, C17, C18, C19, C21, C22, C23, C24, C25, C26, C27, C28, C30, C31, C33, C35, C36, C39, C40, C41, C44, C45, C46, C47, C48, C49, C51, C53, C55, C56: 0u1; C_0805
C15, C20: 10p; C_0603
C32, C34, C42, C43, C50, C54: 0u22; C_0603
D1: USB; D_0805
D2: 12V; D_0805
D3, D10: 3.3V; D_0805
D4: 5V; D_0805
D5: X1 Stop; D_0805
D6: X2 Stop; D_0805
D7: Y1 Stop; D_0805
D8: Y2 Stop; D_0805
D9: D Stop; D_0805
J1: JTAG; Pin_Header_Straight_2x05_Pitch1.27mm
J2: USB; USB_B
J3: POWER IN; VH-4
J4: LASER P; B2B-XH-A
J5: X LIMIT1; B2B-XH-A
J6: WATER FLOW; B3B-XH-A
J7: X LIMIT2; B2B-XH-A
J8: Y LIMIT1; B2B-XH-A
J9: Y LIMIT2; B2B-XH-A
J10: D SWITCH; B2B-XH-A
J11: LASER; B3B-XH-A
J12, J17: Y VREF; Pin_Header_Straight_1x01_Pitch1.00mm
J13: X VREF; Pin_Header_Straight_1x01_Pitch1.00mm
J14: Y1 MOTOR; VH-4
J15: X MOTOR; VH-4
J16: Y2 MOTOR; VH-4
L1: BNX024H01
L4: LI0603G221R-10; R_0603
R1, R11, R12, R13, R14, R18, R29, R33, R67, R69: 10k; R_0603
R2, R3, R5, R7, R8, R25, R30, R31, R53, R54, R62, R63: 4k7; R_0603
R4, R28: 1k5; R_0603
R6, R43, R44, R45, R55, R56, R57, R58, R59, R60: 220R; R_1206
R9, R10, R15, R16, R17, R36, R38: 1k; R_0603
R21, R22: 22R; R_0603
R26, R42: 470R; R_0603
R27: 47R; R_0603
R34, R66, R68: 100k; R_0603
R35, R41, R70, R71: 0R; R_1206
R37, R40, R73, R74, R75, R76: 0R1; R_1206
R39: 2k7; R_0603
R51: 160R; R_1206
R64: 390R; R_0603
R65: 2k4; R_0603
SW1: DHT-1163S
SW2: SSSS213202
TP1, TP2, TP3, TP4: CP-10; Pin_Header_Straight_1x01_Pitch2.54mm
U1, U2, U4: LD1117S; LD1117S33TR
U3: STM32F20XR; LQFP-64_10x10mm_Pitch0.5mm
U5, U11: ADUM1250
U6, U7, U8, U9, U10, U12, U13, U15, U16, U18, U22, U27, U28: TLP2355
U14, U17, U29: TLP291; TLP291(SE
U19: MCP3425
U20, U21, U25: A4982SLPTR
U23: MCP4461; TSSOP-20_4.4x6.5mm_P0.65mm
VR1, VR2: CG0603MLC-05E; C_0603
X1: 7B-25.000MAAJ-T; Oscillator_SMD_Fordahl_DFAS15-4pin_5.0x3.2mm
X2: 9HT10-32.768KDZY-T; C_1206

Connections:
+12P: J3.1, J3.2, L1.1 (B)
A+3.3V: C4.1, C24.2, C27.2, C31.1, C39.1, C42.1, C43.1, C54.1, D3.1 (A), R18.1, R33.1, R34.1, R36.1, R38.1, R39.1, R62.1, R63.1, R66.1, R67.1, R68.1, R69.1, U1.2 (VOUT), U1.TAB (VOUT), U5.8 (VDD2), U11.8 (VDD2), U12.6, U13.6, U15.6, U16.6, U19.5 (VDD), U20.5 (MS1), U20.6 (MS2), U20.10 (VDD), U21.5 (MS1), U21.6 (MS2), U21.10 (VDD), U23.17 (VDD), U25.5 (MS1), U25.6 (MS2), U25.10 (VDD), U27.6, U28.6
A+5V: C8.1, D4.1 (A), J6.1, R27.1, U4.2 (VOUT), U4.TAB (VOUT), U6.6
A+12V: C1.1, C5.1, C7.1, C23.1, C35.2, C36.2, C37.1, C38.1, C40.2, C41.2, C51.2, C52.1, C53.2, D2.1 (A), L1.2 (CB), R2.2, R3.2, R5.2, R7.2, R8.2, R9.1, R10.1, R15.1, R16.1, R17.1, R65.2, U1.3 (IN), U4.3 (IN), U20.16 (VBB1), U20.21 (VBB2), U21.16 (VBB1), U21.21 (VBB2), U25.16 (VBB1), U25.21 (VBB2)
BOOT0: R29.2, U3.60 (BOOT0)
D+3.3V: C6.1, C17.1, C18.1, C19.1, C21.1, C22.1, C30.1, D10.1 (A), J1.1 (VDD), L4.1, R11.1, R12.1, R13.1, R14.1, R30.1, R31.1, R53.1, R54.1, SW2.1, U2.2 (VOUT), U2.TAB (VOUT), U3.1 (VBAT), U3.19 (VDD_4), U3.32 (VDD_1), U3.48 (VDD_2), U3.64 (VDD_3), U5.1 (VDD1), U7.6, U8.6, U9.6, U10.6, U11.1 (VDD1), U18.6, U22.6
D_SWITCH: C49.1, U3.22 (PA6), U18.5
GNDA: C1.2, C4.2, C5.2, C7.2, C8.2, C23.2, C24.1, C27.1, C31.2, C32.2, C33.2, C34.2, C35.1, C36.1, C37.2, C38.2, C39.2, C42.2, C43.2, C46.2, C47.2, C50.2, C51.1, C52.2, C54.2, C56.2, J4.2 (PM), J5.2 (PM), J6.2 (PM), J7.2 (PM), J8.2 (PM), J9.2 (PM), J10.2 (PM), J11.3, L1.4 (CG), R25.2, R26.2, R28.2, R35.2, R37.2, R40.2, R41.2, R51.1, R64.2, R70.2, R71.2, R73.2, R74.2, R75.2, R76.2, TP1.1, TP2.1, TP3.1, U1.1 (GND), U4.1 (GND), U5.5 (GND2), U6.4, U11.5 (GND2), U12.4, U13.4, U14.3, U15.4, U16.4, U17.3, U19.2 (GND), U19.6 (VIN-), U20.13 (GND), U20.24 (GND), U20.PAD (GND_PAD), U21.13 (GND), U21.24 (GND), U21.PAD (GND_PAD), U23.3 (P3B), U23.4 (HVC/A0), U23.7 (VSS), U23.8 (P1B), U23.13 (P0B), U23.16 (A1), U25.13 (GND), U25.24 (GND), U25.PAD (GND_PAD), U27.4, U28.4, U29.3
GNDD: C2.2, C3.2, C6.2, C9.2, C10.2, C11.2, C12.2, C13.2, C14.2, C15.2, C16.2, C17.2, C18.2, C19.2, C20.2, C21.2, C22.2, C25.2, C26.2, C28.2, C30.2, C48.2, C49.2, J1.3 (GND), J1.5 (GND), J1.9 (GND), J2.4 (GND), J2.5 (Shield_1), J2.6 (Shield_2), R1.2, R4.2, R6.2, R41.1, R43.2, R44.2, R45.2, R55.2, R56.2, R57.2, R58.2, R59.2, R60.2, SW1.1, SW2.3, TP4.1, U2.1 (GND), U3.12 (VSSA), U3.18 (VSS_4), U3.63 (VSS_3), U5.4 (GND1), U7.4, U8.4, U9.4, U10.4, U11.4 (GND1), U18.4, U22.4, VR1.1, VR2.1, X1.2, X1.4
GNDPWR: J3.3, J3.4, L1.3 (PSG)
LASER_OUT: U3.39 (PC8), U6.1
unnamed: C9.1, U3.31 (VCAP_1)
unnamed: C10.1, U3.47 (VCAP_2)
unnamed: C32.1, U20.4 (VREG)
unnamed: C33.1, R64.1, R65.1, U19.1 (VIN+)
unnamed: C34.1, U21.4 (VREG)
unnamed: C40.1, U20.3 (VCP)
unnamed: C41.1, U21.3 (VCP)
unnamed: C44.1, U20.1 (CP1)
unnamed: C44.2, U20.2 (CP2)
unnamed: C45.1, U21.1 (CP1)
unnamed: C45.2, U21.2 (CP2)
unnamed: C50.1, U25.4 (VREG)
unnamed: C53.1, U25.3 (VCP)
unnamed: C55.1, U25.1 (CP1)
unnamed: C55.2, U25.2 (CP2)
unnamed: D1.2 (K), R4.1
unnamed: D2.2 (K), R25.1
unnamed: D3.2 (K), R26.1
unnamed: D4.2 (K), R28.1
unnamed: D5.1 (A), R2.1
unnamed: D5.2 (K), J5.1, U7.3
unnamed: D6.1 (A), R3.1
unnamed: D6.2 (K), J7.1, U8.3
unnamed: D7.1 (A), R5.1
unnamed: D7.2 (K), J8.1, U9.3
unnamed: D8.1 (A), R7.1
unnamed: D8.2 (K), J9.1, U10.3
unnamed: D9.1 (A), R8.1
unnamed: D9.2 (K), J10.1, U18.3
unnamed: D10.2 (K), R42.1
unnamed: J2.2 (D-), R22.1, VR2.2
unnamed: J2.3 (D+), R21.1, VR1.2
unnamed: J4.1, R27.2
unnamed: J6.3, U22.1
unnamed: J11.1, U6.5
unnamed: R1.1, U3.28 (PB2)
unnamed: R6.1, U6.3
unnamed: R9.2, U18.1
unnamed: R10.2, U10.1
unnamed: R15.2, U9.1
unnamed: R16.2, U8.1
unnamed: R17.2, U7.1
unnamed: R18.2, U23.15 (*RESET)
unnamed: R29.1, R42.2, SW2.2
unnamed: R33.2, U25.7 (/RESET), U25.9 (/SLEEP)
unnamed: R35.1, U25.8 (ROSC)
unnamed: R36.2, U5.6 (SCL2), U23.5 (SCL)
unnamed: R37.1, U25.20 (SENSE2)
unnamed: R38.2, U5.7 (SDA2), U23.6 (SDA)
unnamed: R39.2, U23.1 (P3A), U23.10 (P1A), U23.11 (P0A)
unnamed: R40.1, U25.17 (SENSE1)
unnamed: R43.1, U27.3
unnamed: R44.1, U28.3
unnamed: R45.1, U29.2
unnamed: R51.2, U22.3
unnamed: R55.1, U12.3
unnamed: R56.1, U13.3
unnamed: R57.1, U14.2
unnamed: R58.1, U15.3
unnamed: R59.1, U16.3
unnamed: R60.1, U17.2
unnamed: R62.2, U11.6 (SCL2), U19.3 (SCL)
unnamed: R63.2, U11.7 (SDA2), U19.4 (SDA)
unnamed: R67.2, U20.7 (/RESET), U20.9 (/SLEEP)
unnamed: R68.2, U17.4, U21.23 (/ENABLE)
unnamed: R69.2, U21.7 (/RESET), U21.9 (/SLEEP)
unnamed: R70.1, U20.8 (ROSC)
unnamed: R71.1, U21.8 (ROSC)
unnamed: R73.1, U20.20 (SENSE2)
unnamed: R74.1, U21.20 (SENSE2)
unnamed: R75.1, U20.17 (SENSE1)
unnamed: R76.1, U21.17 (SENSE1)
unnamed: U15.5, U21.11 (STEP)
unnamed: U16.5, U21.14 (DIR)
OSC32_IN: C15.1, U3.3 (PC14), X2.1
OSC32_OUT: C20.1, U3.4 (PC15), X2.2
OSC_IN: C11.1, U3.5 (PH0/OSC_IN), X1.1
OSC_OUT: C13.1, U3.6 (PH1/OSC_OUT), X1.3
RESET: C12.1, J1.10 (*RST), SW1.2, U3.7 (NRST)
SCL0: R31.2, U3.58 (PB6), U5.3 (SCL1)
SCL1: R54.2, U3.41 (PA8), U11.3 (SCL1)
SDA0: R30.2, U3.59 (PB7), U5.2 (SDA1)
SDA1: R53.2, U3.40 (PC9), U11.2 (SDA1)
TCK: J1.4 (TCK), R13.2, U3.49 (JTCK/SWCLK/PA14)
TDI: J1.8 (TDI), R11.2, U3.50 (JTDI/PA15)
TDO: J1.6 (TDO), R12.2, U3.55 (JTDO/TRACESSW0/PB3)
TMS: J1.2 (TMS), R14.2, U3.46 (JTMS/SWDIO/PA13)
USBM: R22.2, U3.44 (PA11)
USBP: R21.2, U3.45 (PA12)
VBUS: C2.1, C3.1, D1.1 (A), J2.1 (Vbus), U2.3 (IN)
VDDA: C14.1, C16.1, L4.2, U3.13 (VDDA)
WATER_FLOW: U3.33 (PB12), U22.5
X_DIR: U3.9 (PC1), U16.1
X_EN: U3.10 (PC2), U17.1
X_LIMIT1: C25.1, U3.15 (PA1), U7.5
X_LIMIT2: C26.1, U3.16 (PA2), U8.5
X_MOT_1A: J15.3, U21.18 (OUT1A)
X_MOT_1B: J15.4, U21.15 (OUT1B)
X_MOT_2A: J15.2, U21.19 (OUT2A)
X_MOT_2B: J15.1, U21.22 (OUT2B)
X_REF: C47.1, J13.1, U21.12 (REF), U23.12 (P0W)
X_STEP: U3.8 (PC0), U15.1
Y1_DIR: U3.25 (PC5), U13.1
Y1_DIR_A: U13.5, U20.14 (DIR)
Y1_EN: U3.37 (PC6), U14.1
Y1_EN_A: R66.2, U14.4, U20.23 (/ENABLE)
Y1_MOT_1A: J14.3, U20.18 (OUT1A)
Y1_MOT_1B: J14.4, U20.15 (OUT1B)
Y1_MOT_2A: J14.2, U20.19 (OUT2A)
Y1_MOT_2B: J14.1, U20.22 (OUT2B)
Y1_REF: C46.1, J12.1, U20.12 (REF), U23.9 (P1W)
Y1_STEP: U3.24 (PC4), U12.1
Y1_STEP_A: U12.5, U20.11 (STEP)
Y2_DIR: U3.52 (PC11), U28.1
Y2_DIR_A: U25.14 (DIR), U28.5
Y2_EN: U3.53 (PC12), U29.1
Y2_EN_A: R34.2, U25.23 (/ENABLE), U29.4
Y2_MOT_1A: J16.3, U25.18 (OUT1A)
Y2_MOT_1B: J16.4, U25.15 (OUT1B)
Y2_MOT_2A: J16.2, U25.19 (OUT2A)
Y2_MOT_2B: J16.1, U25.22 (OUT2B)
Y2_REF: C56.1, J17.1, U23.2 (P3W), U25.12 (REF)
Y2_STEP: U3.51 (PC10), U27.1
Y2_STEP_A: U25.11 (STEP), U27.5
Y_LIMIT1: C28.1, U3.20 (PA4), U9.5
Y_LIMIT2: C48.1, U3.21 (PA5), U10.5

Notes on the sheet:
Blue
Green
2k7 resistor chosen to give range of VRef with 0R1 sense resistors for full range of current, to use the maximum current cooling would be required.
Digital Current Limit Control
Y-Axis Stepper Driver
X-Axis Stepper Driver
USB
Red
12V Voltage Monitor
Yellow
Limit switch IF D switch IF WATER FLOW IF
Laser signal out
POWER ANALOG
POWER DIGITAL
Common GND
GND PIN
0: Normal Mode 1: DFU Mode

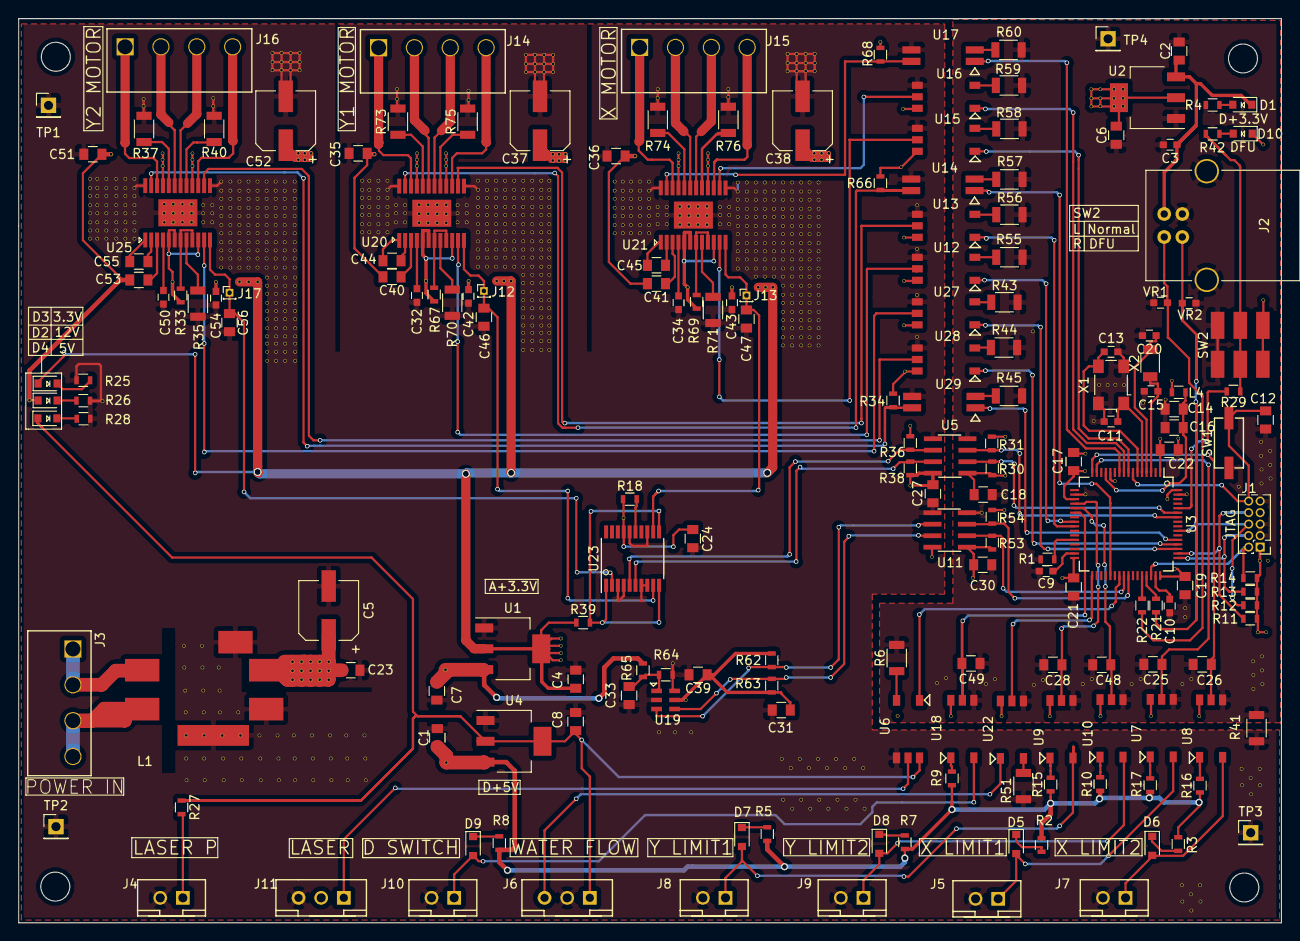
[picture p10: board LaserDSBoard.kicad_pcb from above]

Board: 4 copper layers, 139.5 x 99.9 mm, 184 parts (0 on the bottom side), 137 nets.
