icprog/FaboolDSPcba/(commit log)

2018-02-21 DSコントロール基板改版
    ・2→4層化
    ・Y軸モータードライバ増設(1→2)
    ・コネクタ変更
    ・デジタルポテンショメータ変更
    [LaserDSBoard BOM_20171220.xlsx, LaserDSBoard BOM_20180219.xlsx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]
2018-04-10 ver 2.0
    - DFUモード用のLEDを追加
    -フォトカプラ改修(GND接続)
    - R28 R4 R65 パッドサイズを0603に変更
    - 部品表 1k パッドサイズ1206→0603
    -TPL0401 PADピッチ誤り修正（TO-SOT23-6→カスタムPAD）
    -TP穴径変更
    [LaserDSBoard BOM_20180301.xlsx, LaserDSBoard BOM_20180301_5式製造時在庫情報追記.xlsx, LaserDSBoard BOM_20180403.xlsx, LaserDSBoard BOM_20180409.xlsx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]
2018-05-11 Ver2.0.0
    [schematic]
    ・デジタルポテンショメータ MCP4461に戻す
    ・フォトカプラ ENの経路(U14,U17,U29)
    TLP2355→TLP291に変更
    [AW]
    ・回路図変更に伴うAW変更
    ・モータドライバ回りビア増加
    ・SW2の向きを反転
    ・部品実装マークをシルクで追加
    [LaserDSBoard BOM_20180417.xlsx, LaserDSBoard BOM_20180423.xlsx, LaserDSBoard BOM_20180425.xlsx, LaserDSBoard BOM_20180426.xlsx, LaserDSBoard BOM_20180508.xlsx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]
2018-05-30 Ver2.0.1
    ・WATER FLOW 電源をA+3.3V→A+5.0Vにつなぎ変え
    ・R51 抵抗値変更
    220Ω→160Ω
    [LaserDSBoard BOM_20180519.xlsx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]
2018-05-30 Ver2.0.1
    BOM修正(MCP4461 個数修正)
    [LaserDSBoard BOM_20180519.xlsx, LaserDSBoard BOM_20180530.xlsx]
2018-06-04 Ver2.0.1
    ガーバーデータに実装用XY座標データ(.pos)を追加
    それに伴いガーバーデータのタイムスタンプ更新(内容は前pushと変更なし)
    [LaserDSBoard-B.Cu.gbl, LaserDSBoard-B.Mask.gbs, LaserDSBoard-B.Paste.gbp, LaserDSBoard-B.SilkS.gbo, LaserDSBoard-Edge.Cuts.gm1, LaserDSBoard-F.Cu.gtl, LaserDSBoard-F.Mask.gts, LaserDSBoard-F.Paste.gtp]
2018-10-25 Ver2.0.2
    部品表更新
    20180607 → 20181025
    [LaserDSBoard BOM_20180219.xlsx, LaserDSBoard BOM_20180301.xlsx, LaserDSBoard BOM_20180301_5式製造時在庫情報追記.xlsx, LaserDSBoard BOM_20180403.xlsx, LaserDSBoard BOM_20180409.xlsx, LaserDSBoard BOM_20180417.xlsx, LaserDSBoard BOM_20180423.xlsx, LaserDSBoard BOM_20180425.xlsx]
